CharlieW112/PROJ300/CAD Files/Downloaded Part Files/Power Socket/IEC320-C14 BACK.jpg

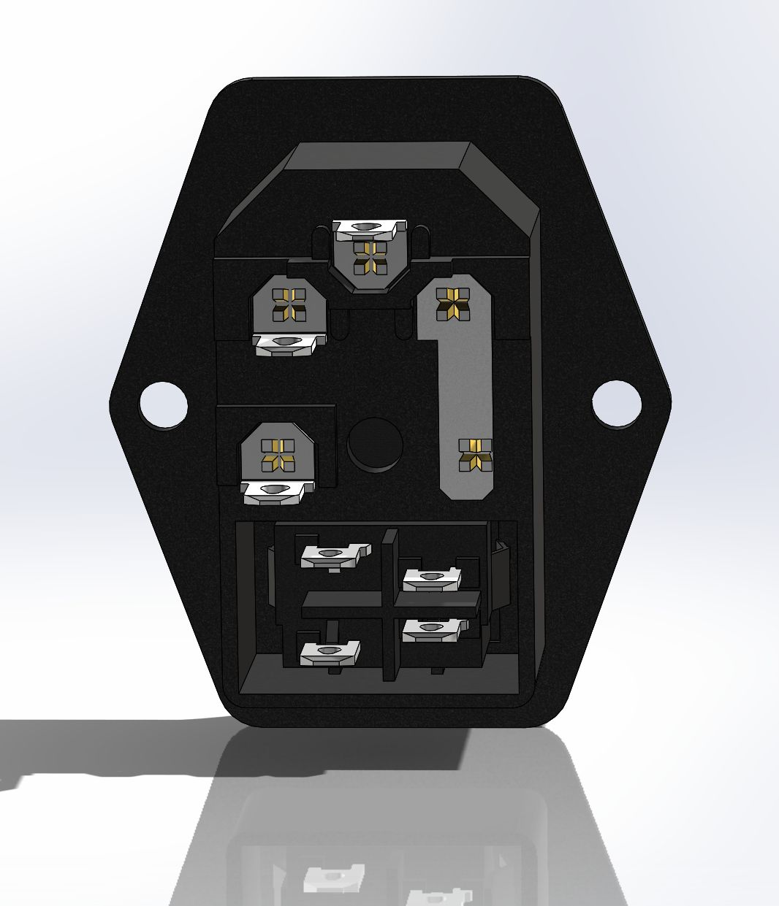
CAD Files/Downloaded Part Files/Power Socket/IEC320-C14 BACK.jpg
