CharlieW112/PROJ300/CAD Files/Downloaded Part Files/Power Socket/IEC320-C14 FRONT.jpg

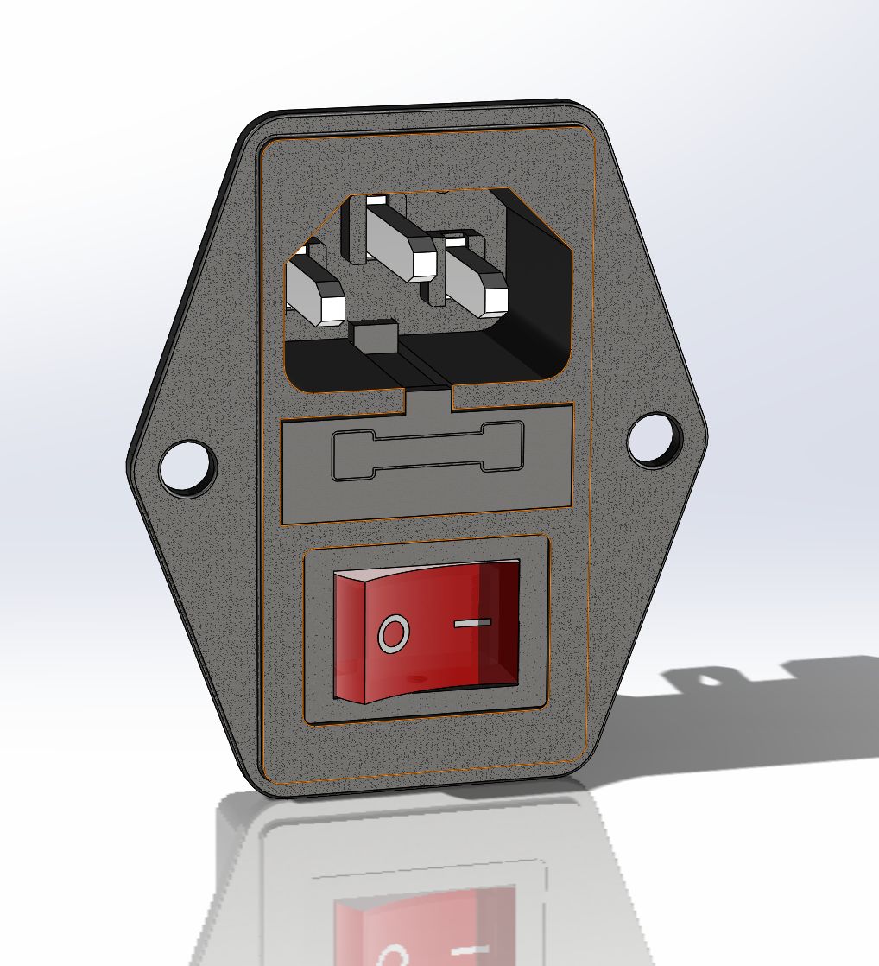
CAD Files/Downloaded Part Files/Power Socket/IEC320-C14 FRONT.jpg
