CharlieW112/PROJ300/CAD Files/Downloaded Part Files/3.5 LCD/AliExpress Dimensions.jpg

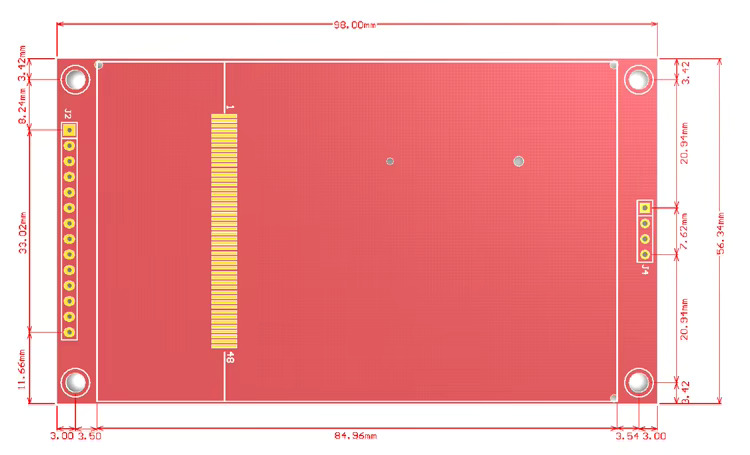
CAD Files/Downloaded Part Files/3.5 LCD/AliExpress Dimensions.jpg
