CharlieW112/PROJ300/CAD Files/Downloaded Part Files/5mm RGB LED/2.png

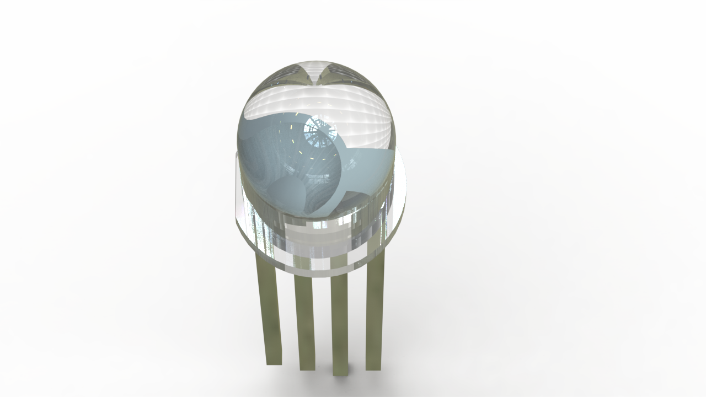
CAD Files/Downloaded Part Files/5mm RGB LED/2.png
