CharlieW112/PROJ300/CAD Files/Downloaded Part Files/Binding Posts/Low-Current/Rendering1.PNG

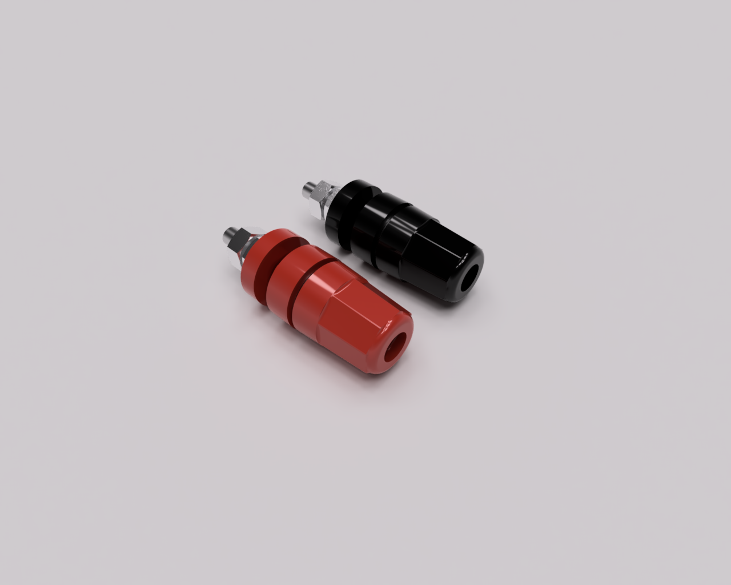
CAD Files/Downloaded Part Files/Binding Posts/Low-Current/Rendering1.PNG
