CharlieW112/PROJ300/CAD Files/Downloaded Part Files/Ethernet Port/RJ45 PanelMount.jpg

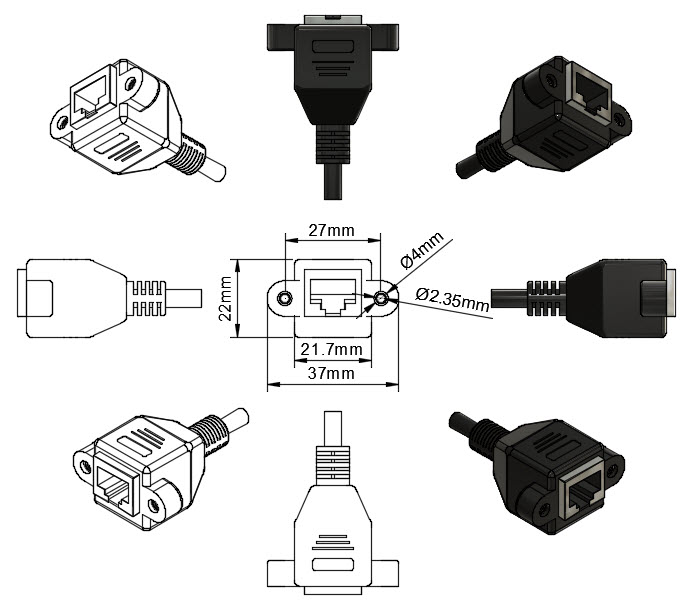
CAD Files/Downloaded Part Files/Ethernet Port/RJ45 PanelMount.jpg
