CharlieW112/PROJ300/CAD Files/Downloaded Part Files/Fans/80x80x25/80x80x25 fan.306.jpg

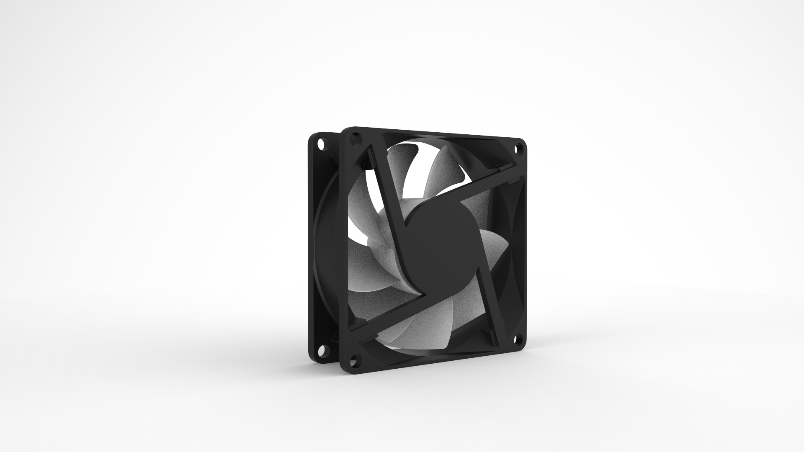
CAD Files/Downloaded Part Files/Fans/80x80x25/80x80x25 fan.306.jpg
