CharlieW112/PROJ300/CAD Files/Downloaded Part Files/Membrane Keypad/keypad-16keymembrane.jpg

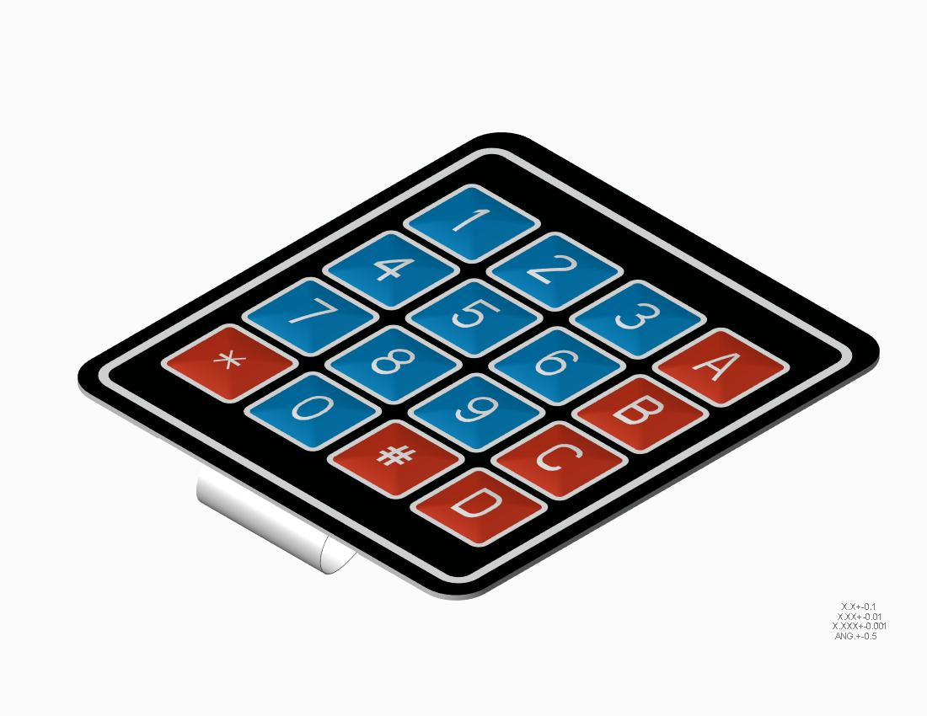
CAD Files/Downloaded Part Files/Membrane Keypad/keypad-16keymembrane.jpg
