CharlieW112/PROJ300/CAD Files/Downloaded Part Files/Power Line Filter/CW4EL2-10A-T EMI.jpg

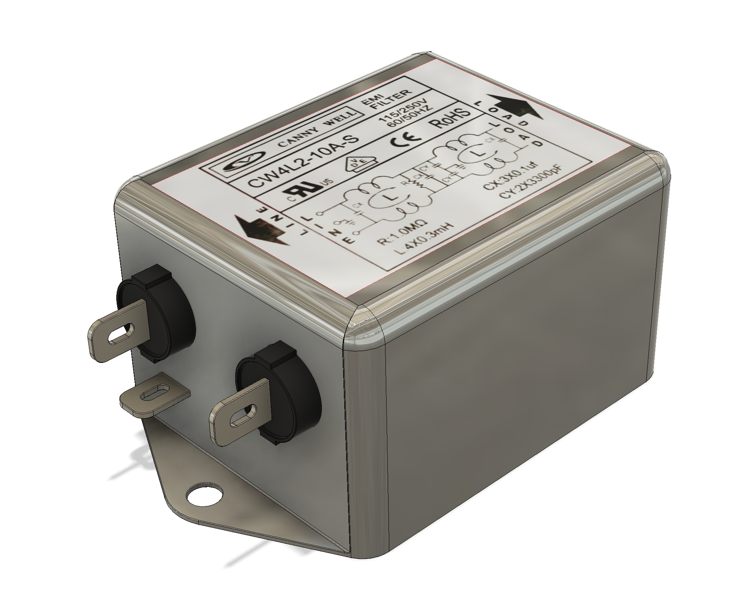
CAD Files/Downloaded Part Files/Power Line Filter/CW4EL2-10A-T EMI.jpg
