CharlieW112/PROJ300/LTSpice/Test Setups/VCCS V2/VCCS Simple Schematic.png

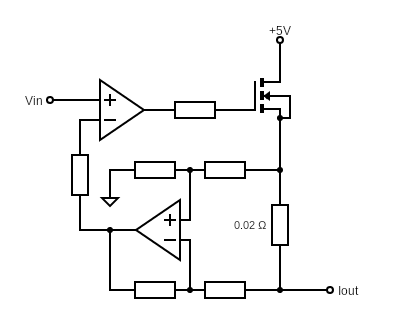
LTSpice/Test Setups/VCCS V2/VCCS Simple Schematic.png
