CharlieW112/PROJ300/CAD Files/Downloaded Part Files/Fans/80x80x25/80x80x25 9 blade fan.SLDASM

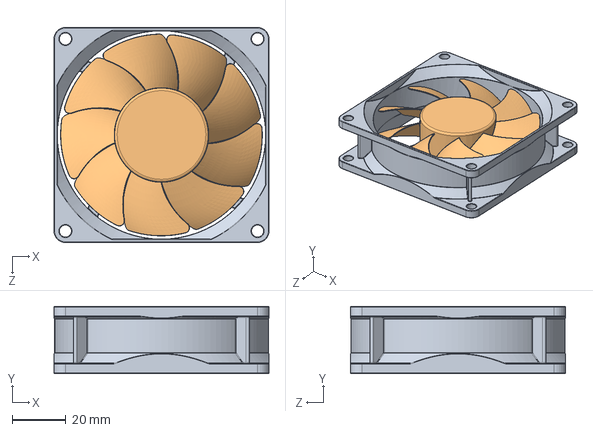
[picture p20: CAD file, 2025-05-07]
CAD Files/Downloaded Part Files/Fans/80x80x25/80x80x25 9 blade fan.SLDASM
80.0 x 25.0 x 80.0 mm
80x80x25 fan frame
80x80x25 fan blade
