CharlieW112/PROJ300/CAD Files/Downloaded Part Files/5mm RGB LED/Led RGB 5mm.STEP

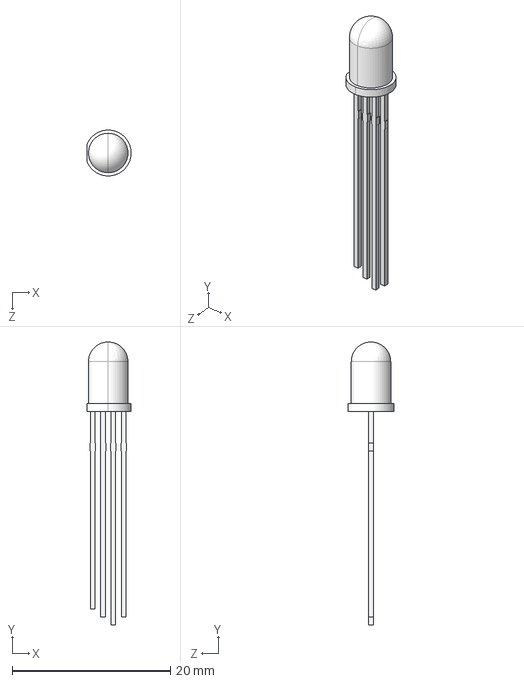
[picture p21: CAD file, 2025-05-07]
CAD Files/Downloaded Part Files/5mm RGB LED/Led RGB 5mm.STEP
5.60 x 35.8 x 5.80 mm
Lente^Led RGB 5mm
Terminais^Led RGB 5mm
