CharlieW112/PROJ300/CAD Files/Downloaded Part Files/Ethernet Port/RJ45 PanelMount.stp

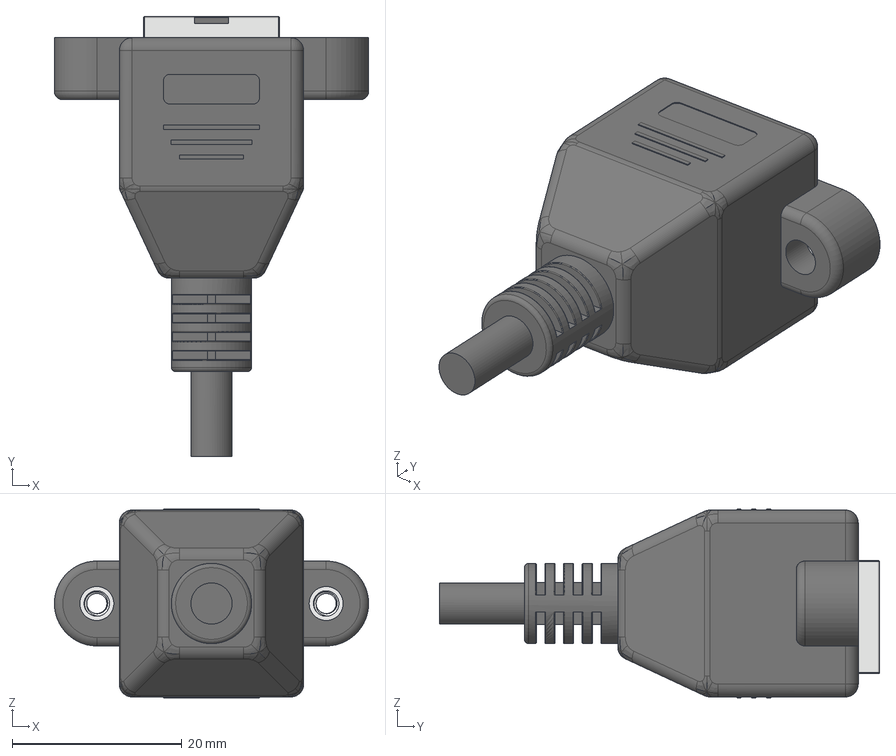
[picture p23: CAD file, 2025-05-07]
CAD Files/Downloaded Part Files/Ethernet Port/RJ45 PanelMount.stp
37.0 x 51.8 x 22.2 mm
RJ45
MetalSheet
M3 - nut 92497A200 v1 x 2
