CharlieW112/PROJ300/CAD Files/Downloaded Part Files/Fans/80x80x25/80x80x25 fan frame.SLDPRT

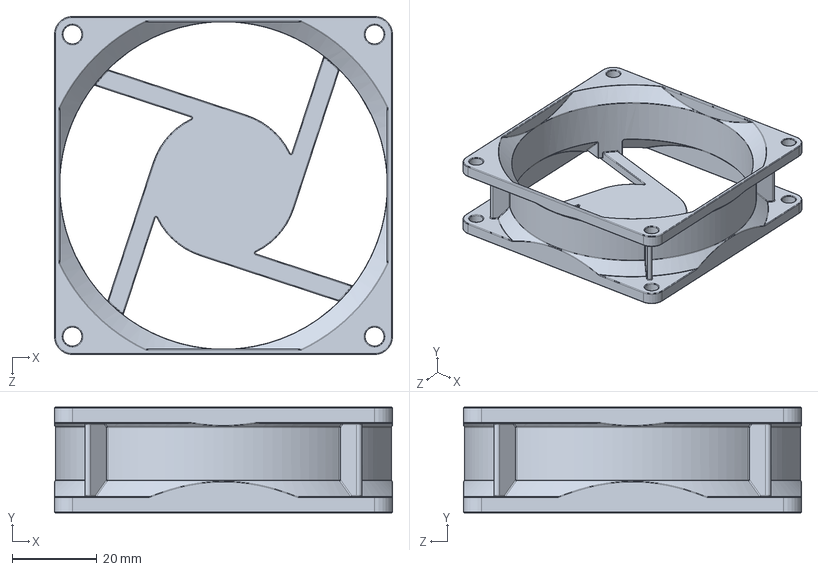
[picture p24: CAD file, 2025-05-07]
CAD Files/Downloaded Part Files/Fans/80x80x25/80x80x25 fan frame.SLDPRT
80.0 x 25.0 x 80.0 mm
