CharlieW112/PROJ300/CAD Files/Downloaded Part Files/Fans/Fan Adapter.stl

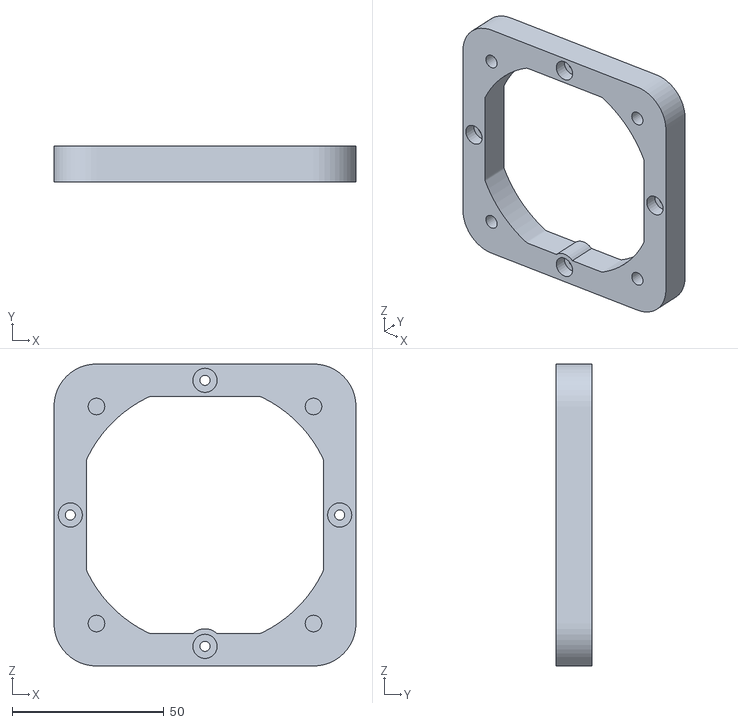
[picture p25: CAD file, 2025-05-07]
CAD Files/Downloaded Part Files/Fans/Fan Adapter.stl
99.5 x 12.0 x 99.5
