CharlieW112/PROJ300/CAD Files/Downloaded Part Files/Heatsinks/Outline1.dxf

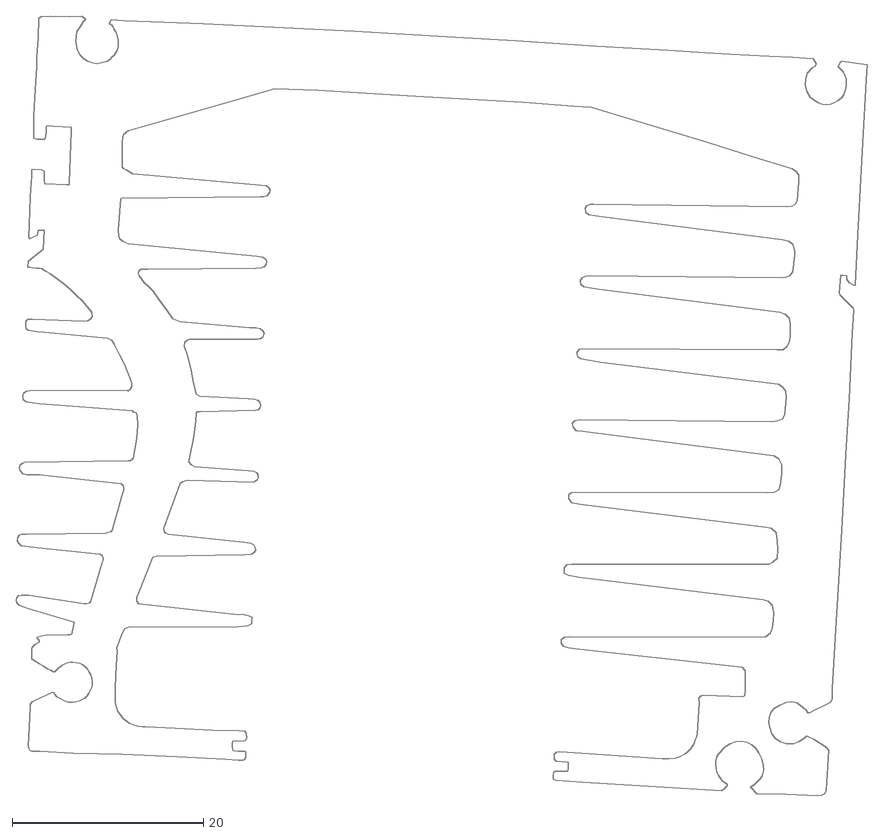
[picture p26: CAD file, 2025-05-07]
CAD Files/Downloaded Part Files/Heatsinks/Outline1.dxf
89.0 x 81.5
