CharlieW112/PROJ300/CAD Files/Downloaded Part Files/Mains Switch Indicating/PB1973GxxxxILEFx.stp

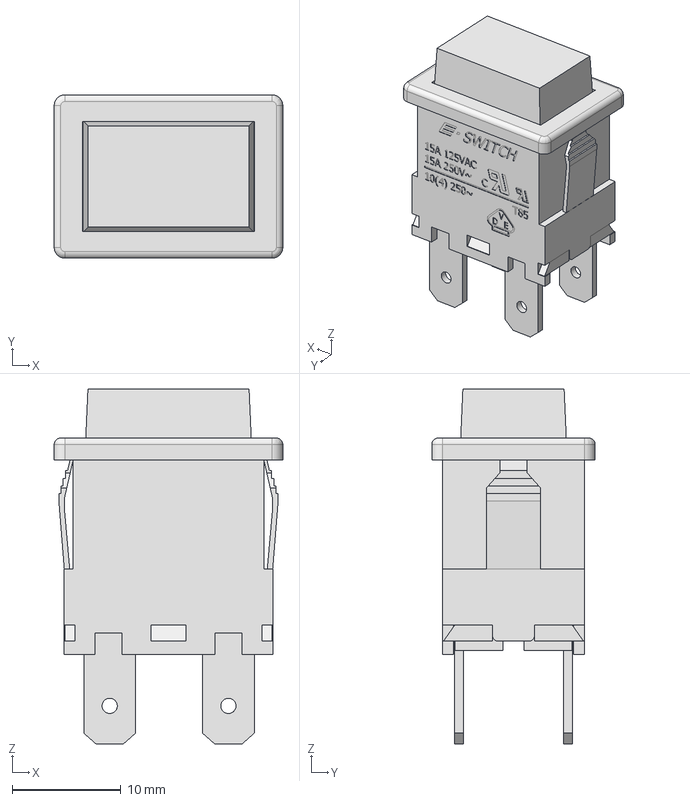
[picture p27: CAD file, 2025-05-07]
CAD Files/Downloaded Part Files/Mains Switch Indicating/PB1973GxxxxILEFx.stp
21.0 x 15.0 x 32.6 mm
