CharlieW112/PROJ300/CAD Files/Downloaded Part Files/Power Line Filter/CW4EL2-10A-T EMI v2.step

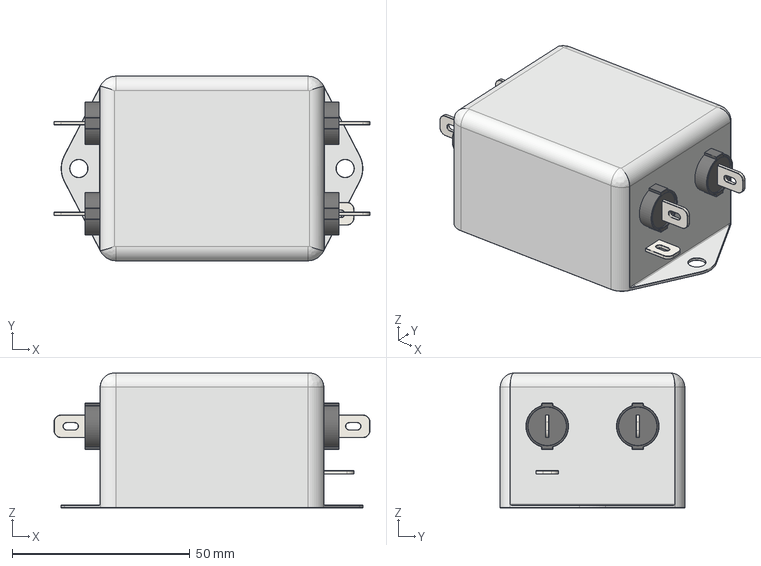
[picture p28: CAD file, 2025-05-07]
CAD Files/Downloaded Part Files/Power Line Filter/CW4EL2-10A-T EMI v2.step
89.0 x 52.0 x 38.0 mm
