CharlieW112/PROJ300/CAD Files/Downloaded Part Files/Rotary Encoder/pec11r-4x25f-sxxxx.stp

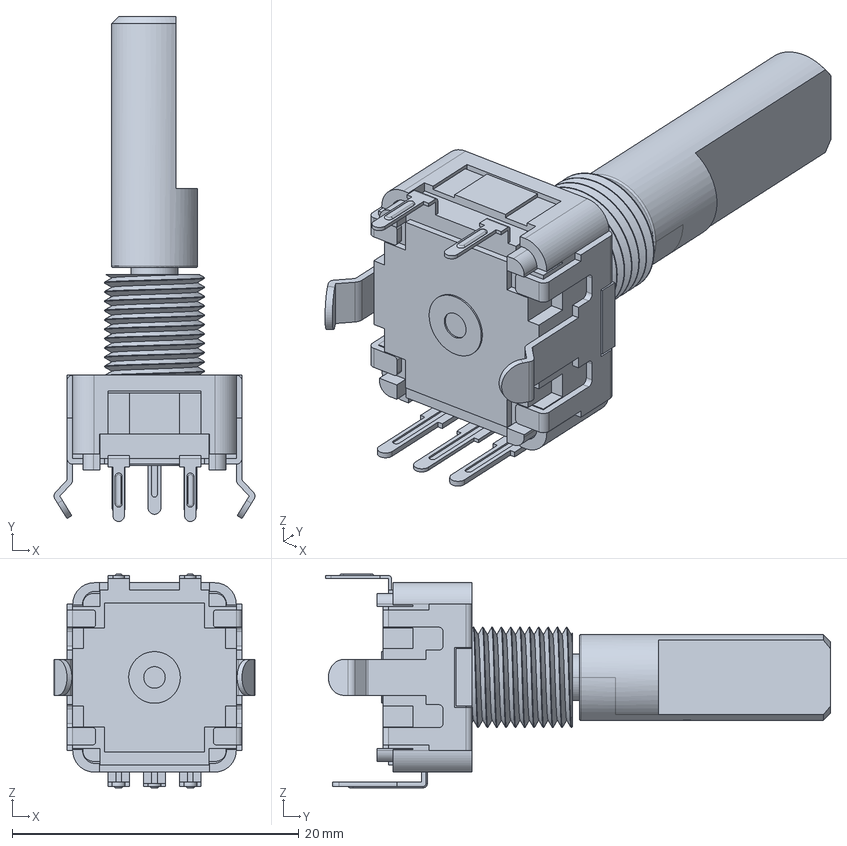
[picture p30: CAD file, 2025-05-07]
CAD Files/Downloaded Part Files/Rotary Encoder/pec11r-4x25f-sxxxx.stp
14.0 x 35.2 x 14.9 mm
