CharlieW112/PROJ300/CAD Files/Downloaded Part Files/Transistors/TO3.STEP

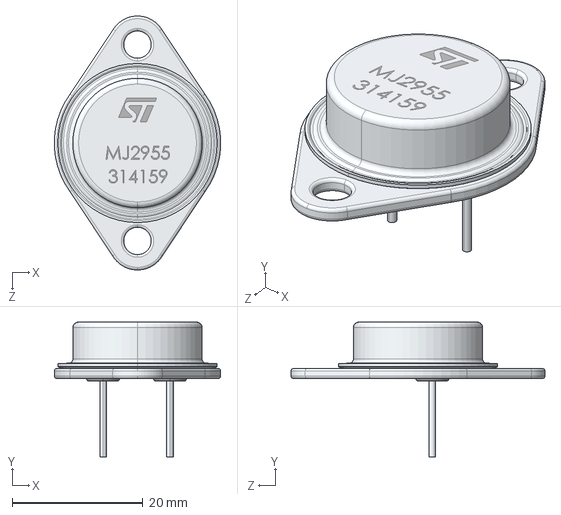
[picture p31: CAD file, 2025-05-07]
CAD Files/Downloaded Part Files/Transistors/TO3.STEP
25.5 x 20.7 x 38.9 mm
