CharlieW112/PROJ300/CAD Files/STL Files/Dust Filters/SMALL TOOL.stl

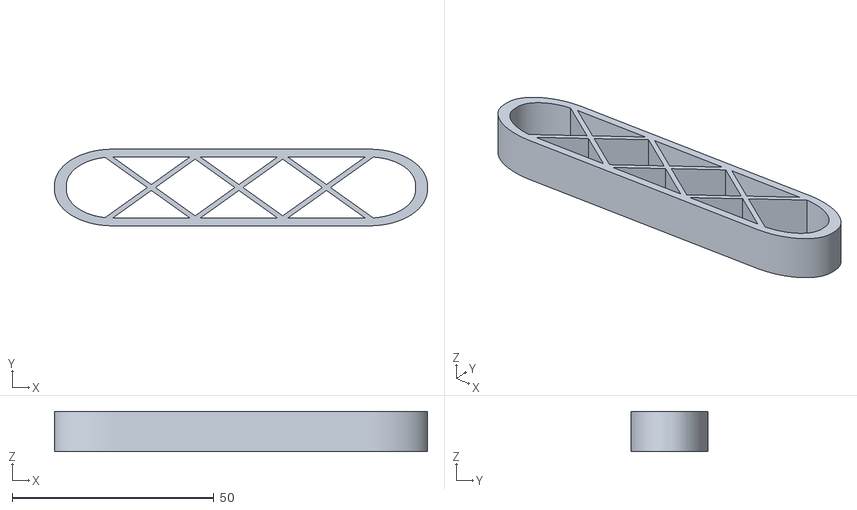
[picture p32: CAD file, 2025-05-07]
CAD Files/STL Files/Dust Filters/SMALL TOOL.stl
92.5 x 19.0 x 10.00
