CharlieW112/PROJ300/CAD Files/STL Files/Rotary Encoder Knob.stl

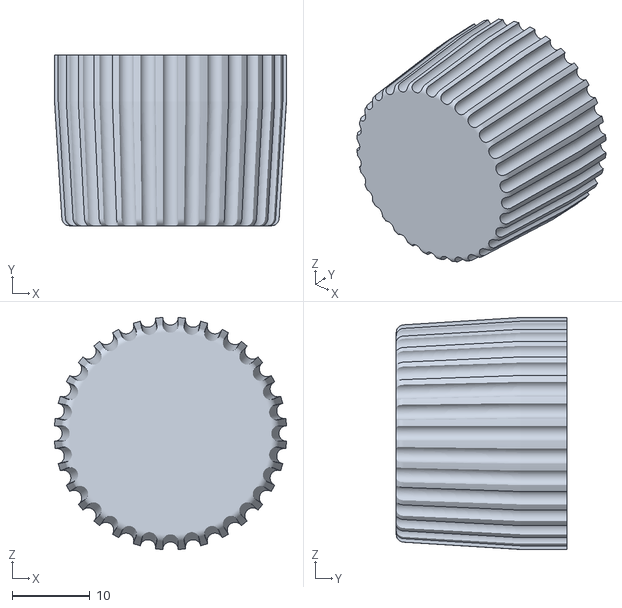
[picture p33: CAD file, 2025-05-07]
CAD Files/STL Files/Rotary Encoder Knob.stl
29.9 x 22.0 x 29.9
