CharlieW112/PROJ300/KiCAD/PWM Board/PWM Board/PWM Board.step

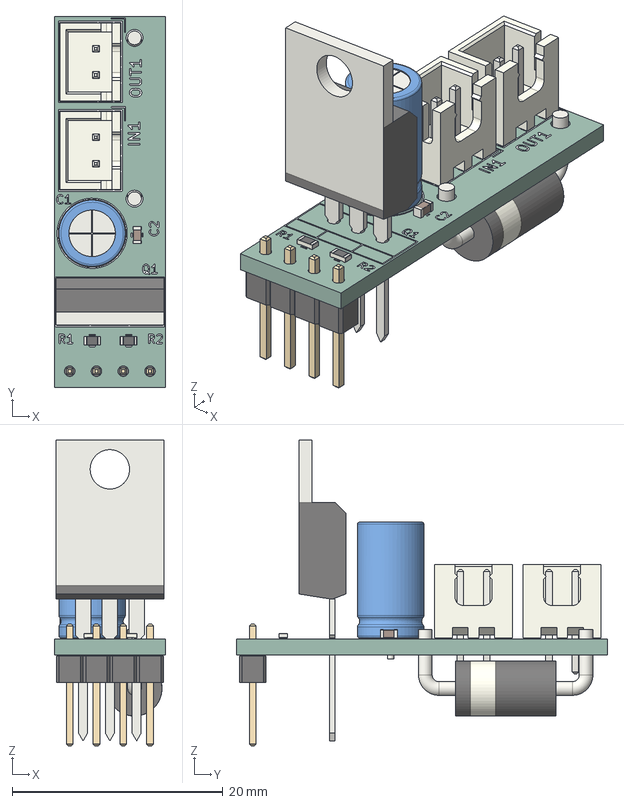
[picture p35: CAD file, 2025-05-07]
KiCAD/PWM Board/PWM Board/PWM Board.step
10.5 x 35.2 x 29.0 mm
JST_XH_B2B-XH-A_1x02_P2.50mm_Vertical x 2
C_0603_1608Metric
R_0603_1608Metric x 2
TO-220-3_Vertical
C_Radial_D6.3mm_H11.0mm_P2.50mm
D_DO-201AD_P15.24mm_Horizontal
PinHeader_1x04_P2.54mm_Vertical
PWM Board_silkscreen
PWM Board_PCB
