CharlieW112/PROJ300/CAD Files/Downloaded Part Files/Fans/80x80x25/80x80x25 fan blade.SLDPRT

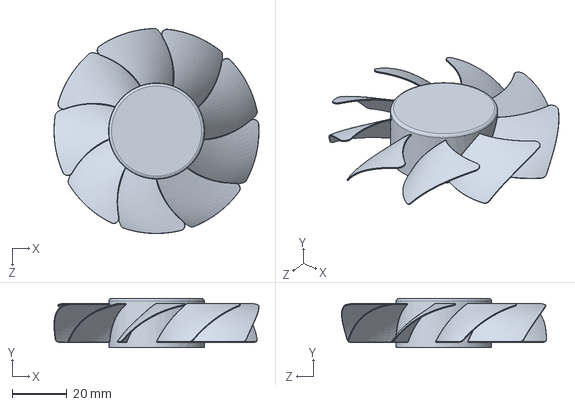
[picture p36: CAD file, 2025-05-07]
CAD Files/Downloaded Part Files/Fans/80x80x25/80x80x25 fan blade.SLDPRT
75.1 x 18.0 x 75.1 mm
