CharlieW112/PROJ300/CAD Files/STL Files/Dust Filters/MEDIUM Outer Ring.stl

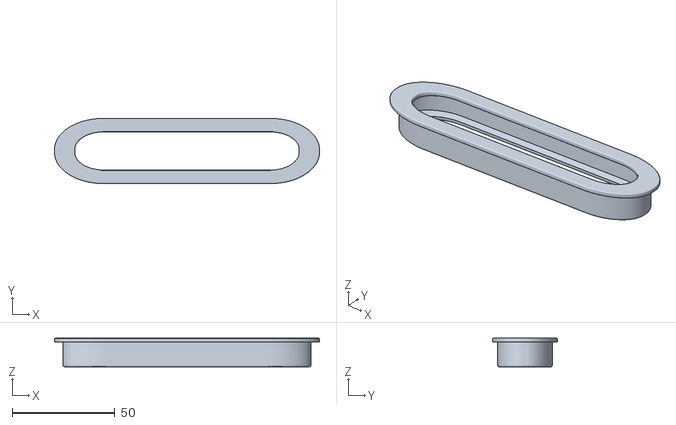
[picture p37: CAD file, 2025-05-07]
CAD Files/STL Files/Dust Filters/MEDIUM Outer Ring.stl
129.0 x 31.7 x 14.0
