CharlieW112/PROJ300/CAD Files/STL Files/Fan Dust Filter.stl

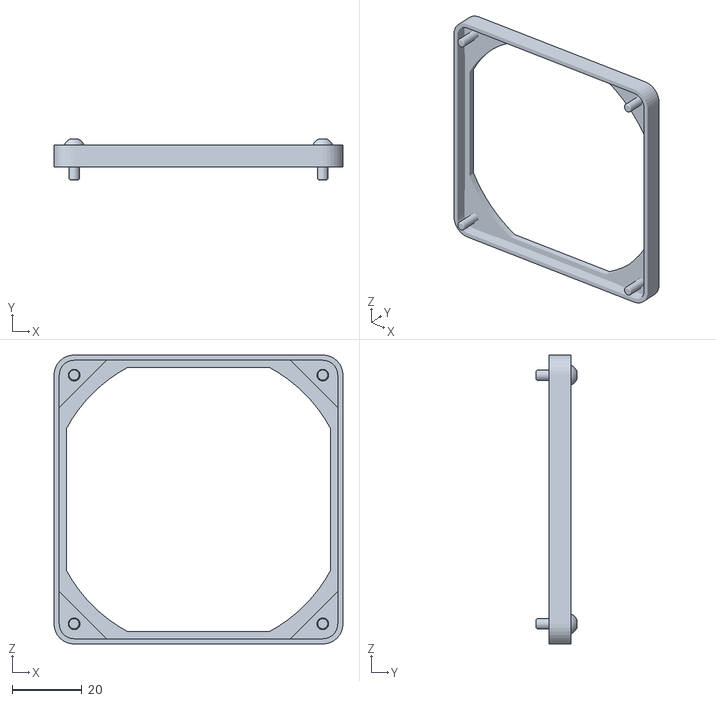
[picture p38: CAD file, 2025-05-07]
CAD Files/STL Files/Fan Dust Filter.stl
83.1 x 11.6 x 83.1
