CharlieW112/PROJ300/CAD Files/STL Files/Dust Filters/SMALL Inner Ring.stl

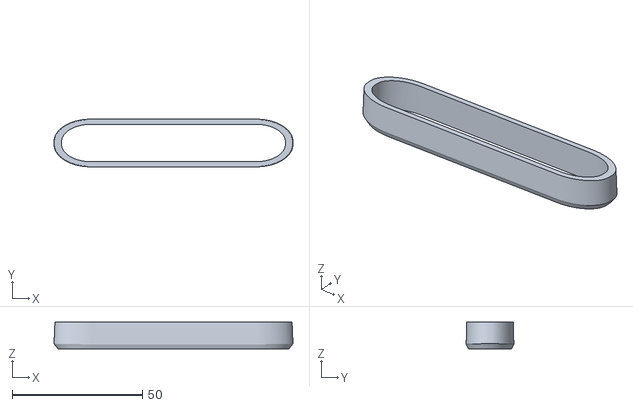
[picture p39: CAD file, 2025-05-07]
CAD Files/STL Files/Dust Filters/SMALL Inner Ring.stl
91.8 x 18.3 x 10.2
