CharlieW112/PROJ300/CAD Files/STL Files/Dust Filters/LARGE Inner Ring.3mf

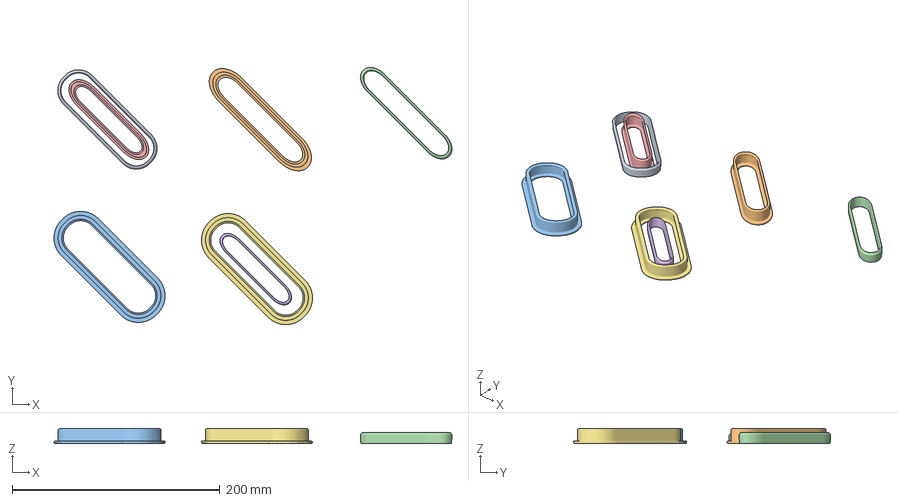
[picture p40: CAD file, 2025-05-07]
CAD Files/STL Files/Dust Filters/LARGE Inner Ring.3mf
383.2 x 247.6 x 14.0 mm
LARGE Inner Ring.stl
MEDIUM Outer Ring.stl
LARGE Outer Ring.stl x 2
MEDIUM Inner Ring.stl
SMALL Outer Ring.stl
SMALL Inner Ring.stl
