CharlieW112/PROJ300/CAD Files/STL Files/Right Dust Covers.stl

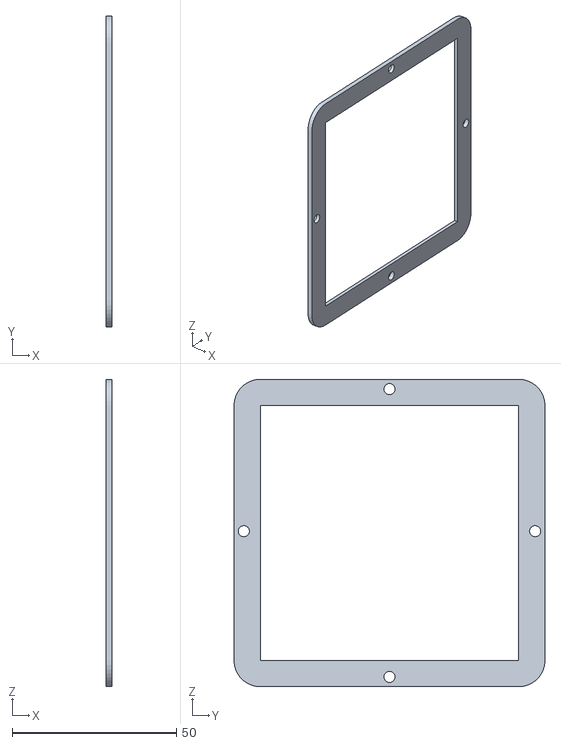
[picture p41: CAD file, 2025-05-07]
CAD Files/STL Files/Right Dust Covers.stl
1.80 x 94.8 x 93.6
