CharlieW112/PROJ300/CAD Files/STL Files/Dust Filters/MEDIUM Inner Ring.stl

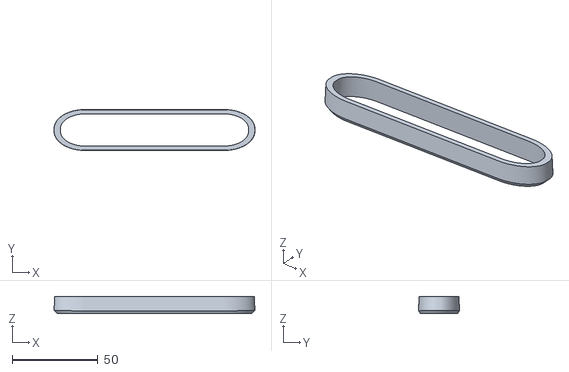
[picture p42: CAD file, 2025-05-07]
CAD Files/STL Files/Dust Filters/MEDIUM Inner Ring.stl
116.9 x 23.8 x 10.1
