CharlieW112/PROJ300/CAD Files/STL Files/Front Outer Ring.stl

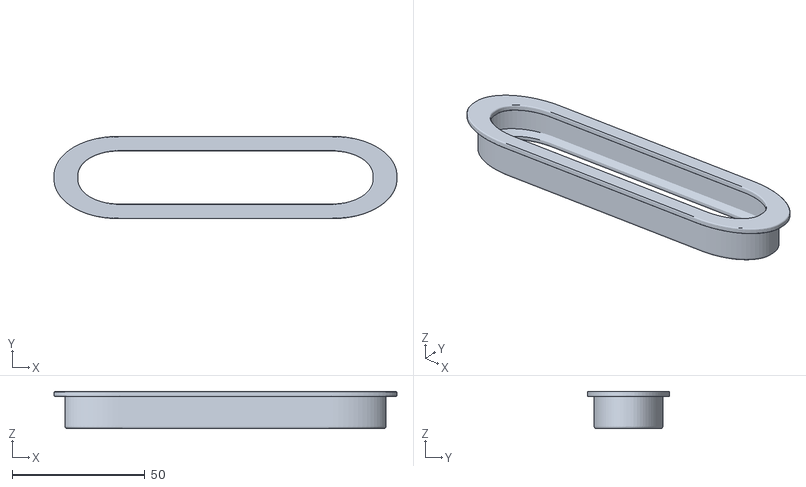
[picture p43: CAD file, 2025-05-07]
CAD Files/STL Files/Front Outer Ring.stl
129.0 x 30.9 x 14.0
