CharlieW112/PROJ300/CAD Files/STL Files/Inner Ring.stl

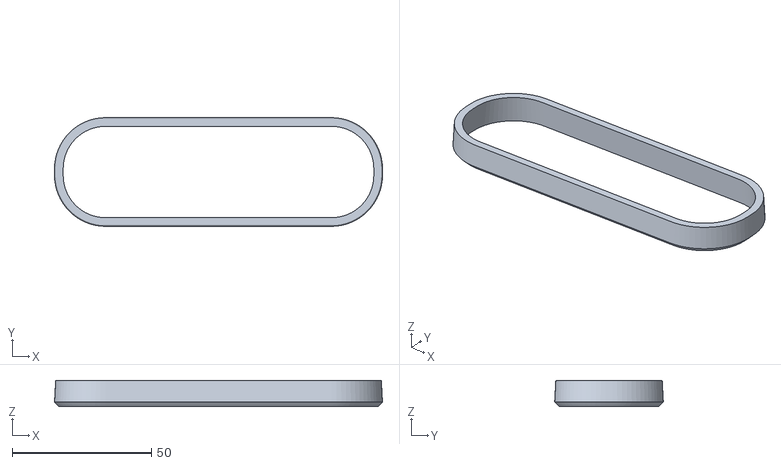
[picture p45: CAD file, 2025-05-07]
CAD Files/STL Files/Inner Ring.stl
117.6 x 39.0 x 9.50
