CharlieW112/PROJ300/CAD Files/STL Files/Binding Post Insulator.stl

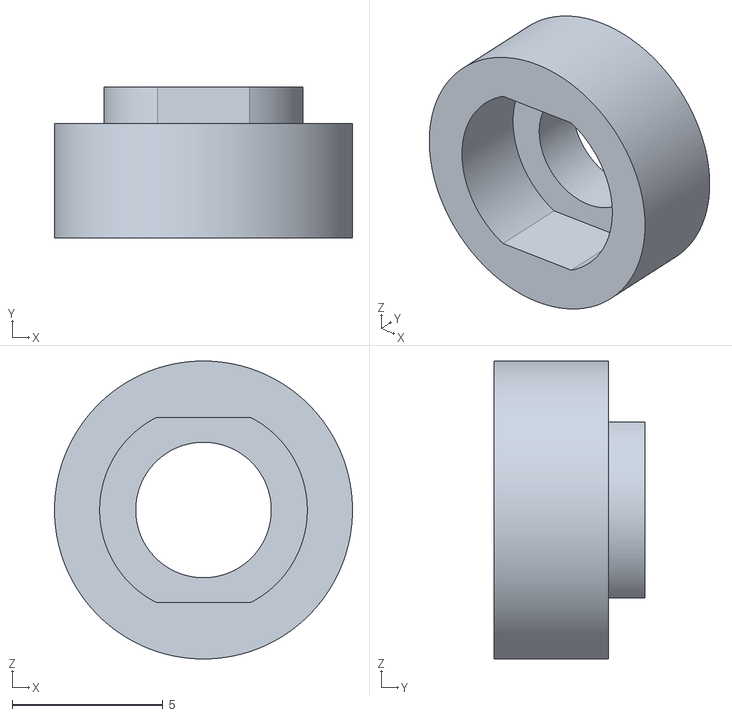
[picture p46: CAD file, 2025-05-07]
CAD Files/STL Files/Binding Post Insulator.stl
9.90 x 5.00 x 9.90
