CharlieW112/PROJ300/CAD Files/STL Files/Dust Filters/SMALL Outer Ring.stl

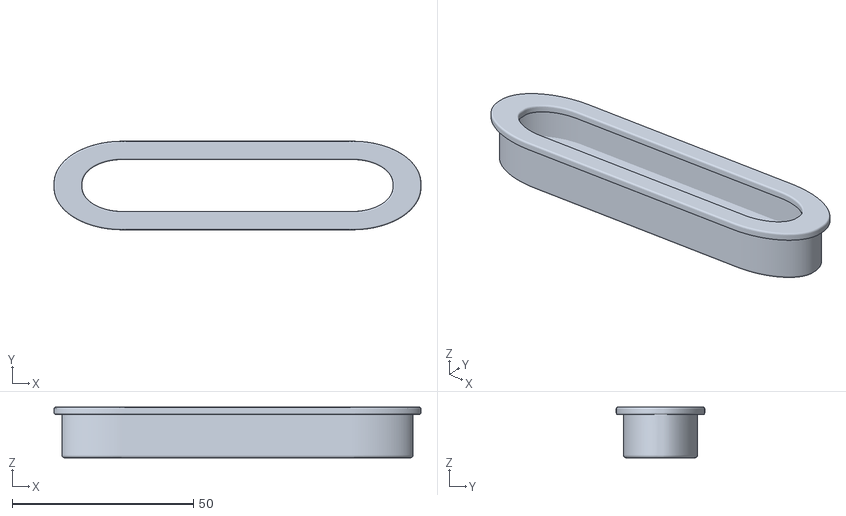
[picture p47: CAD file, 2025-05-07]
CAD Files/STL Files/Dust Filters/SMALL Outer Ring.stl
101.3 x 24.5 x 14.0
