CharlieW112/PROJ300/CAD Files/STL Files/Display Bezel.stl

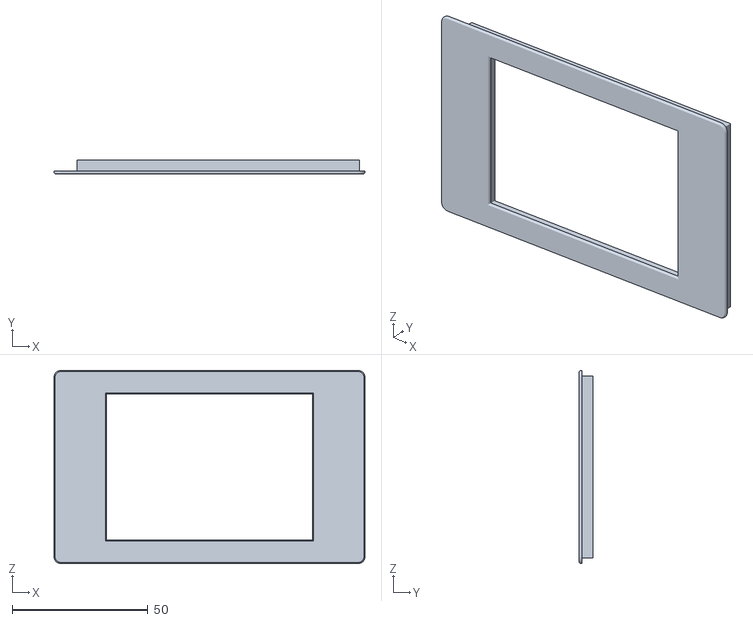
[picture p48: CAD file, 2025-05-07]
CAD Files/STL Files/Display Bezel.stl
114.4 x 5.10 x 71.0
