CharlieW112/PROJ300/CAD Files/STL Files/Mesh Temporary Spacer.stl

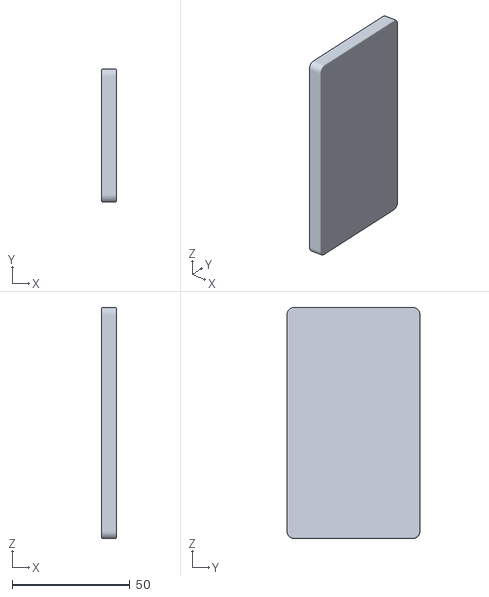
[picture p49: CAD file, 2025-05-07]
CAD Files/STL Files/Mesh Temporary Spacer.stl
6.50 x 56.4 x 98.0
