CharlieW112/PROJ300/CAD Files/STL Files/Rear Dust Filter Outline.stl

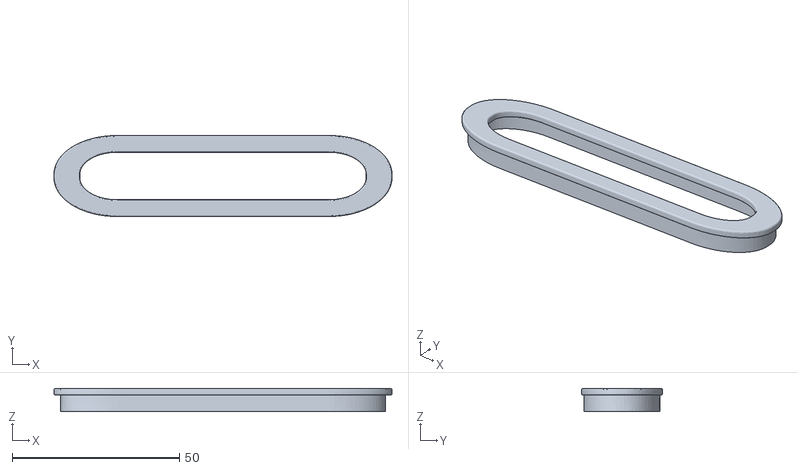
[picture p50: CAD file, 2025-05-07]
CAD Files/STL Files/Rear Dust Filter Outline.stl
101.1 x 24.2 x 7.00
