CharlieW112/PROJ300/CAD Files/STL Files/Outer Ring.stl

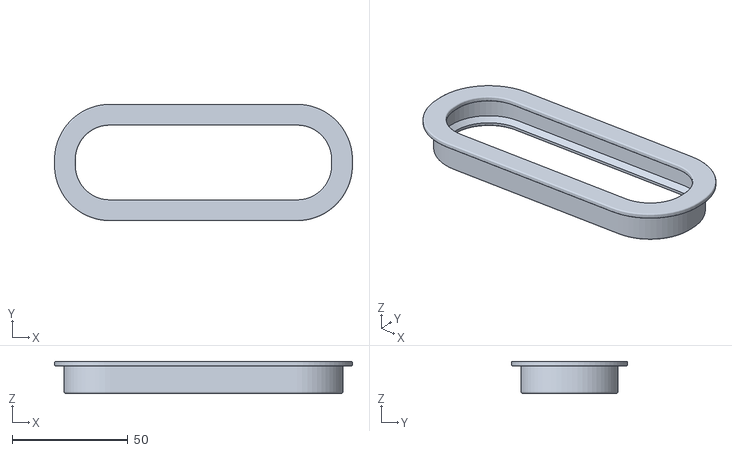
[picture p51: CAD file, 2025-05-07]
CAD Files/STL Files/Outer Ring.stl
129.0 x 50.4 x 14.0
