CharlieW112/PROJ300/CAD Files/STL Files/PSU Bracket.stl

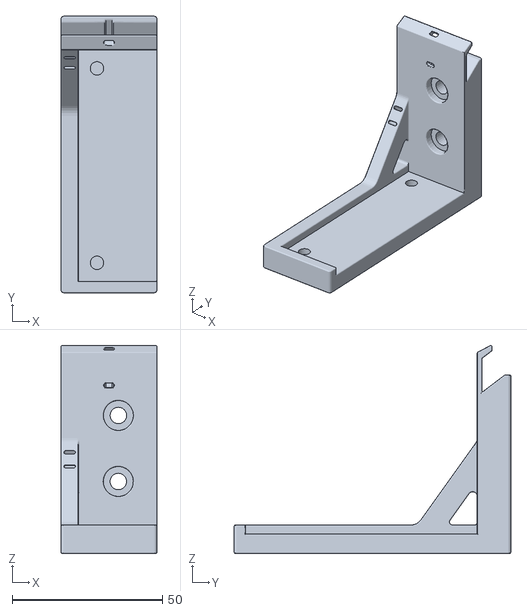
[picture p52: CAD file, 2025-05-07]
CAD Files/STL Files/PSU Bracket.stl
32.0 x 92.2 x 69.3
