CharlieW112/PROJ300/CAD Files/STL Files/M3 Spacer.stl

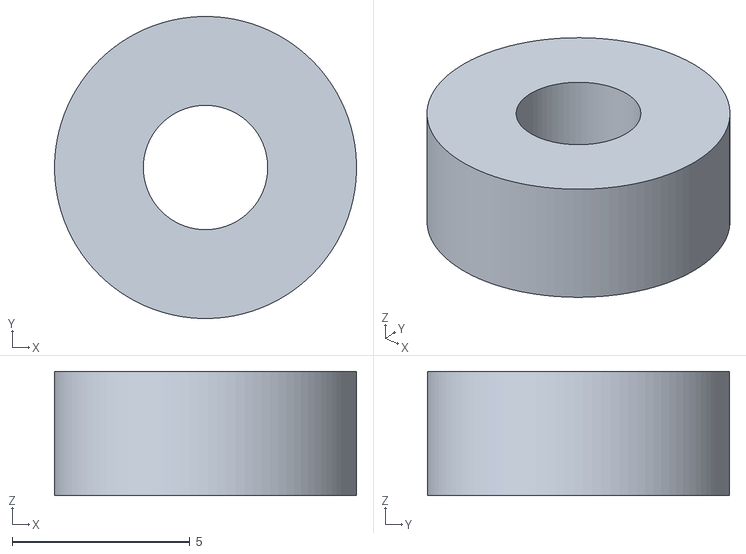
[picture p53: CAD file, 2025-05-07]
CAD Files/STL Files/M3 Spacer.stl
8.50 x 8.50 x 3.50
