CharlieW112/PROJ300/CAD Files/STL Files/Small Outer Ring Scaled Up.stl

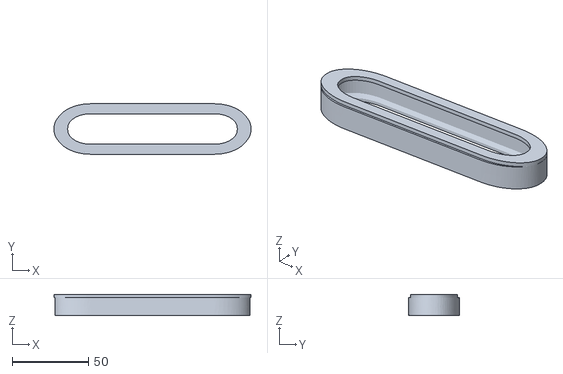
[picture p54: CAD file, 2025-05-07]
CAD Files/STL Files/Small Outer Ring Scaled Up.stl
129.0 x 33.1 x 14.0
