CharlieW112/PROJ300/CAD Files/STL Files/Front Inner Ring.stl

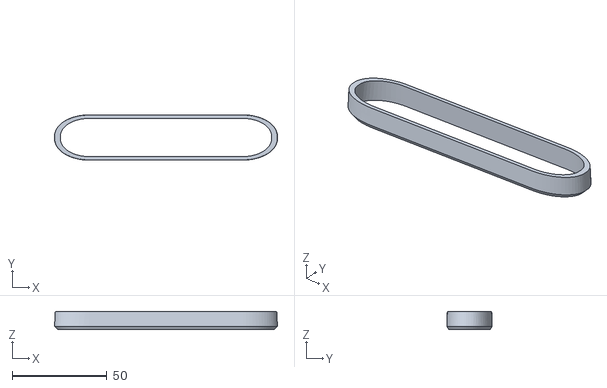
[picture p55: CAD file, 2025-05-07]
CAD Files/STL Files/Front Inner Ring.stl
117.6 x 23.9 x 9.50
