CharlieW112/PROJ300/CAD Files/STL Files/Cable Clip.stl

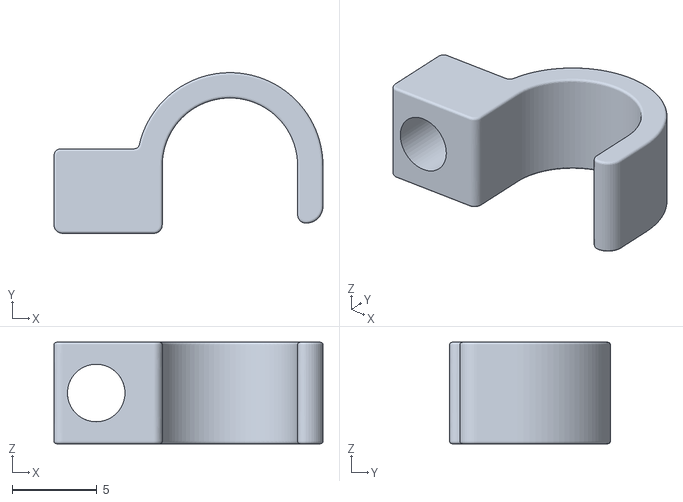
[picture p56: CAD file, 2025-05-07]
CAD Files/STL Files/Cable Clip.stl
15.9 x 9.50 x 6.00
