CharlieW112/PROJ300/CAD Files/STL Files/Filter Clip.stl

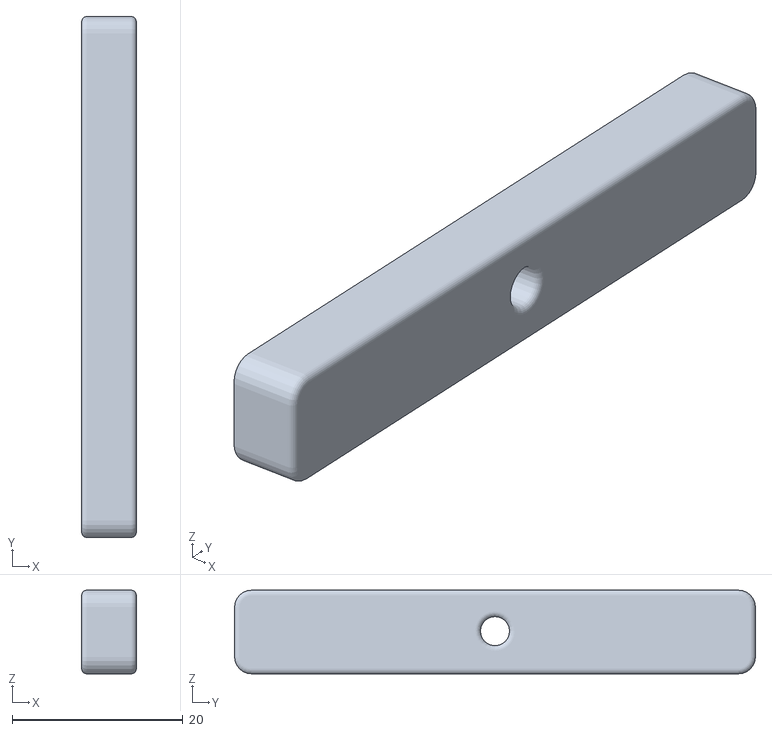
[picture p57: CAD file, 2025-05-07]
CAD Files/STL Files/Filter Clip.stl
6.40 x 61.0 x 9.80
