CharlieW112/PROJ300/CAD Files/STL Files/Body1.stl

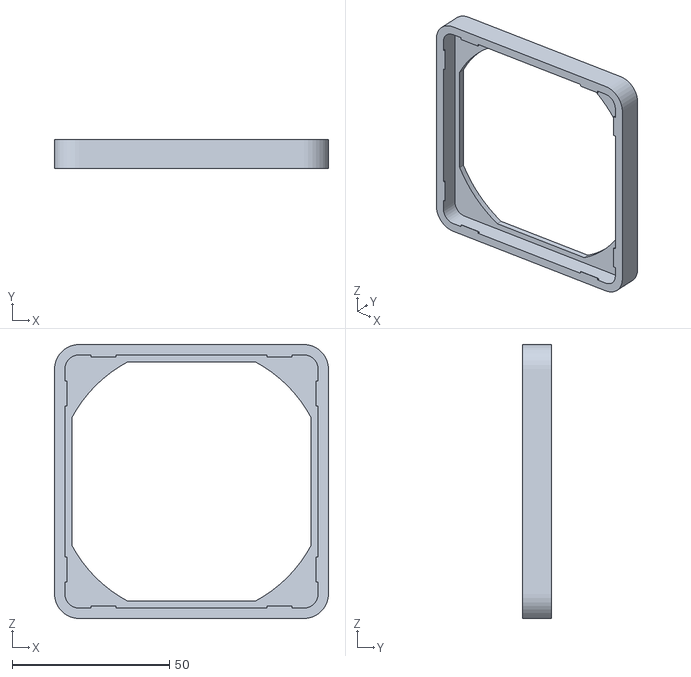
[picture p59: CAD file, 2025-05-07]
CAD Files/STL Files/Body1.stl
87.1 x 9.12 x 87.1
