CharlieW112/PROJ300/CAD Files/STL Files/Outer Body .stl

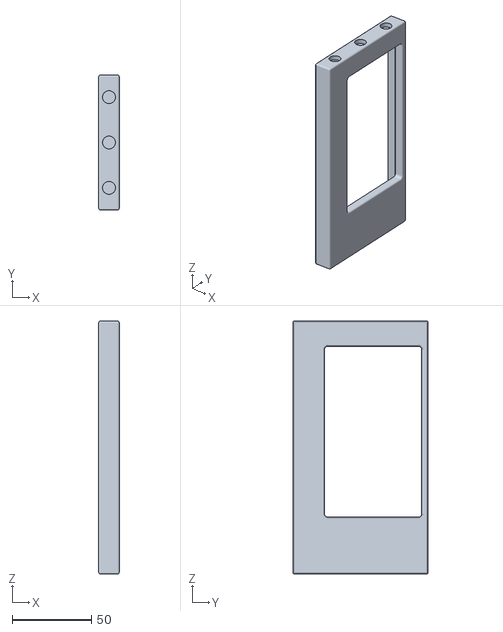
[picture p60: CAD file, 2025-05-07]
CAD Files/STL Files/Outer Body .stl
13.0 x 85.4 x 160.0
