CharlieW112/PROJ300/CAD Files/STL Files/Left Dust Cover.stl

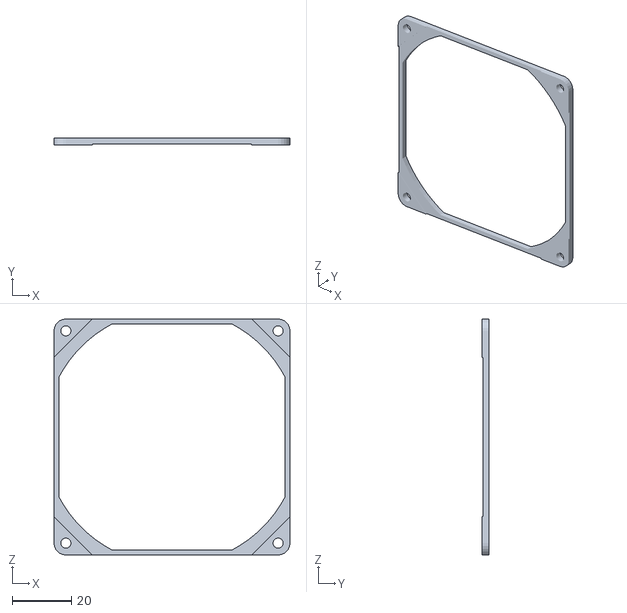
[picture p61: CAD file, 2025-05-07]
CAD Files/STL Files/Left Dust Cover.stl
79.5 x 2.50 x 79.5
