CharlieW112/PROJ300/LTSpice/Test Setups/VCCS V2/Handwritten_2025-03-16_183225.jpg

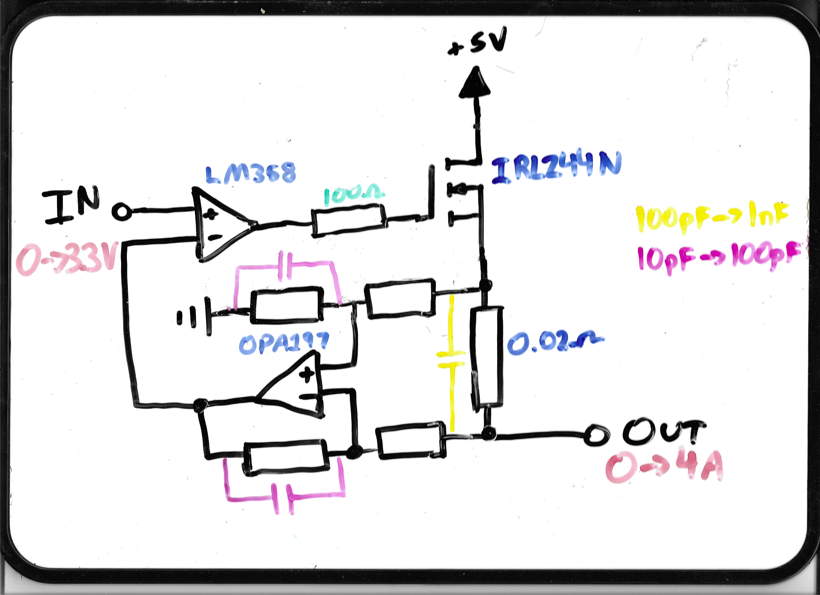
LTSpice/Test Setups/VCCS V2/Handwritten_2025-03-16_183225.jpg
