CharlieW112/PROJ300/CAD Files/V1/Programmable DC Electronic Load Drawing Complete V1 v1.pdf

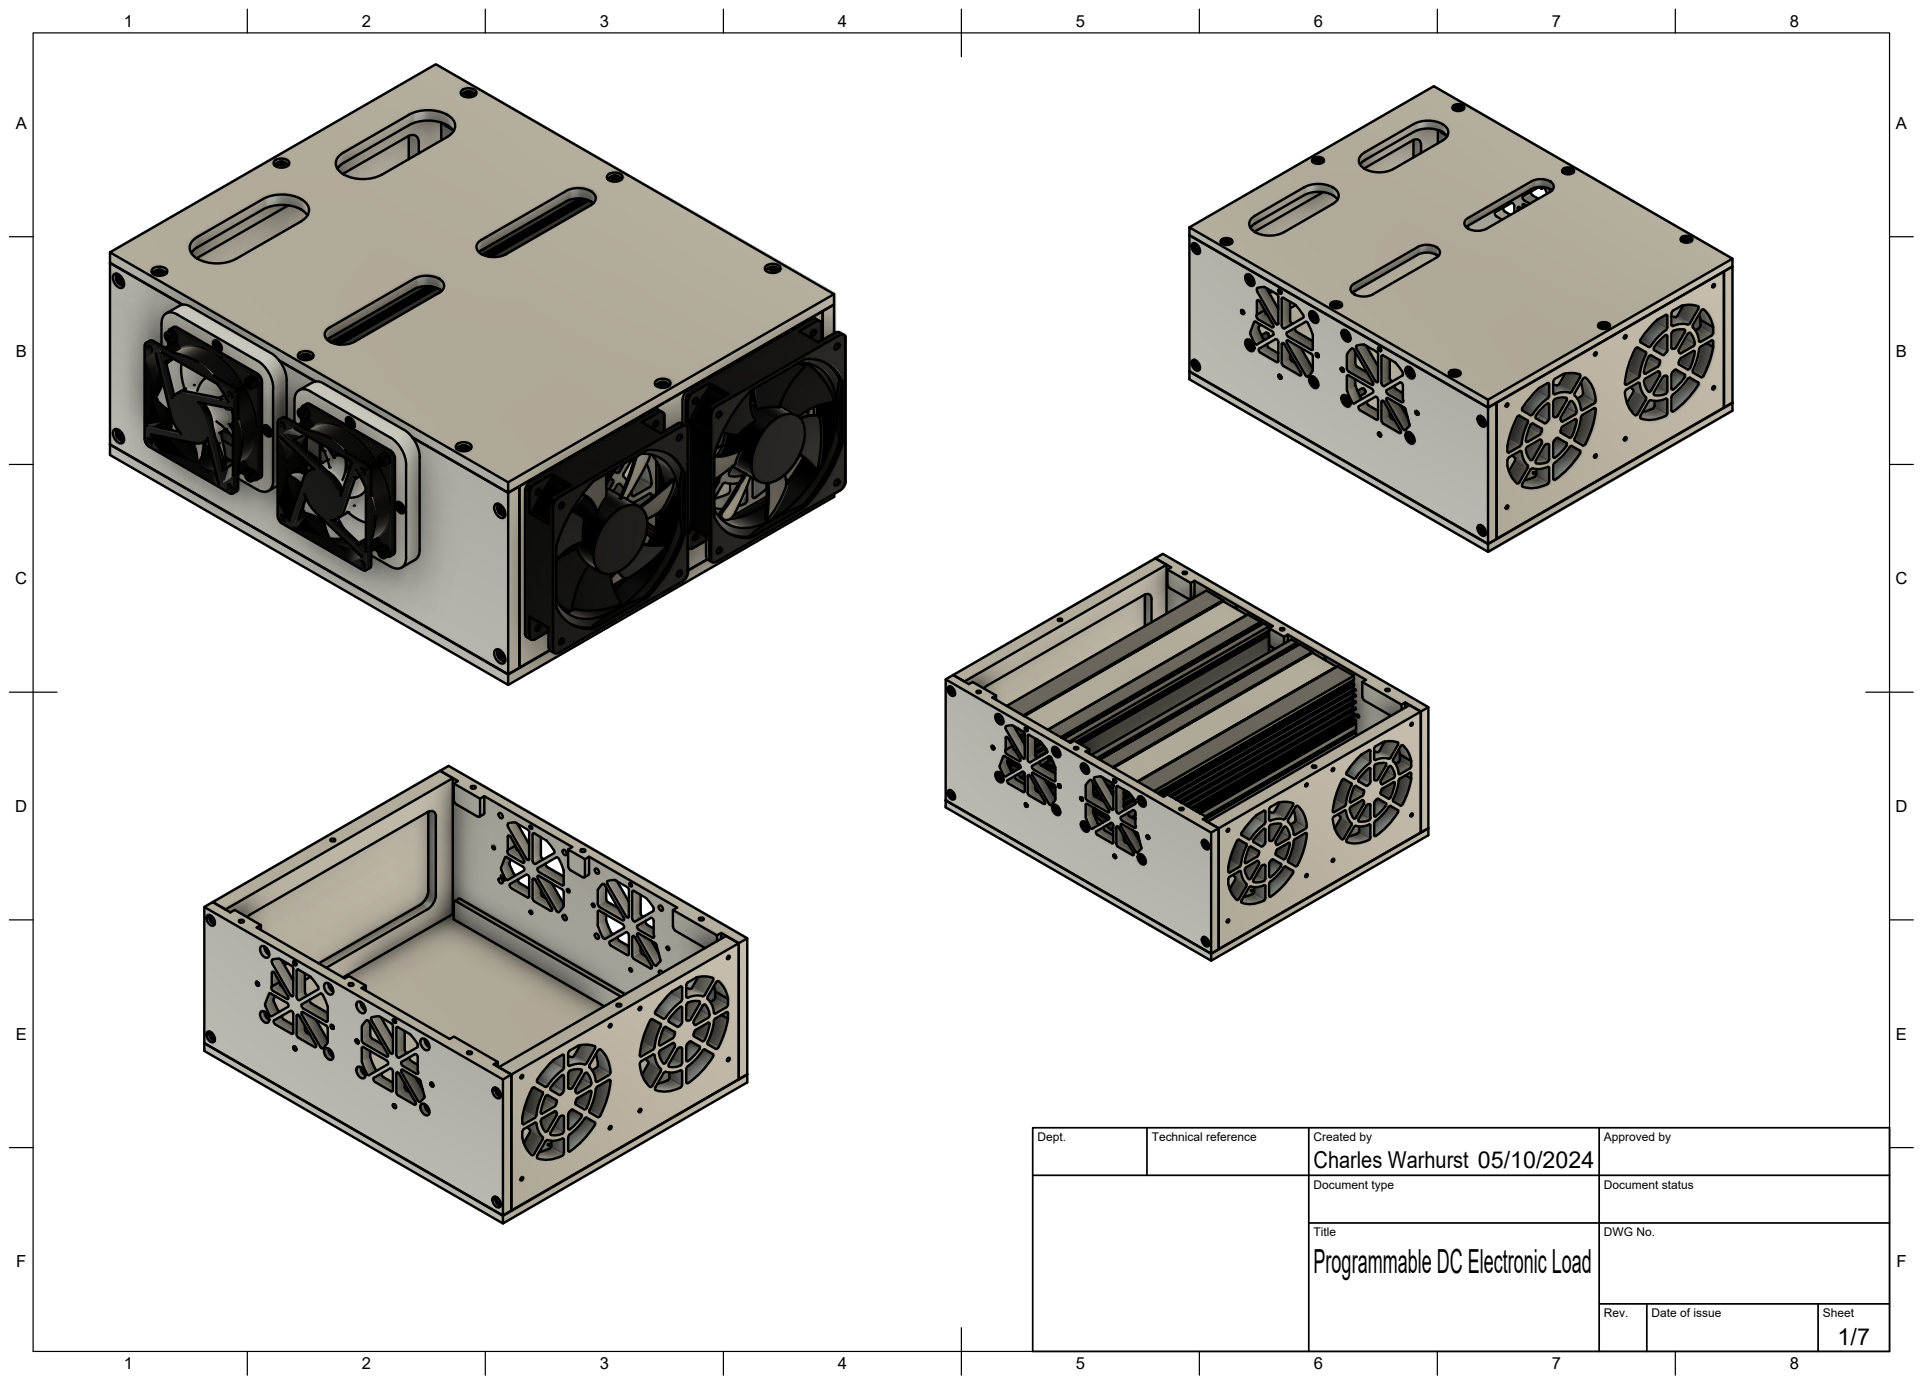
[picture p63: page 1]
Title; DWG No.; Rev.; Date of issue; Sheet

Dept. | Technical reference | Created by Charles Warhurst 05/10/2024 | Approved by

Document type | Document status

Programmable DC Electronic Load

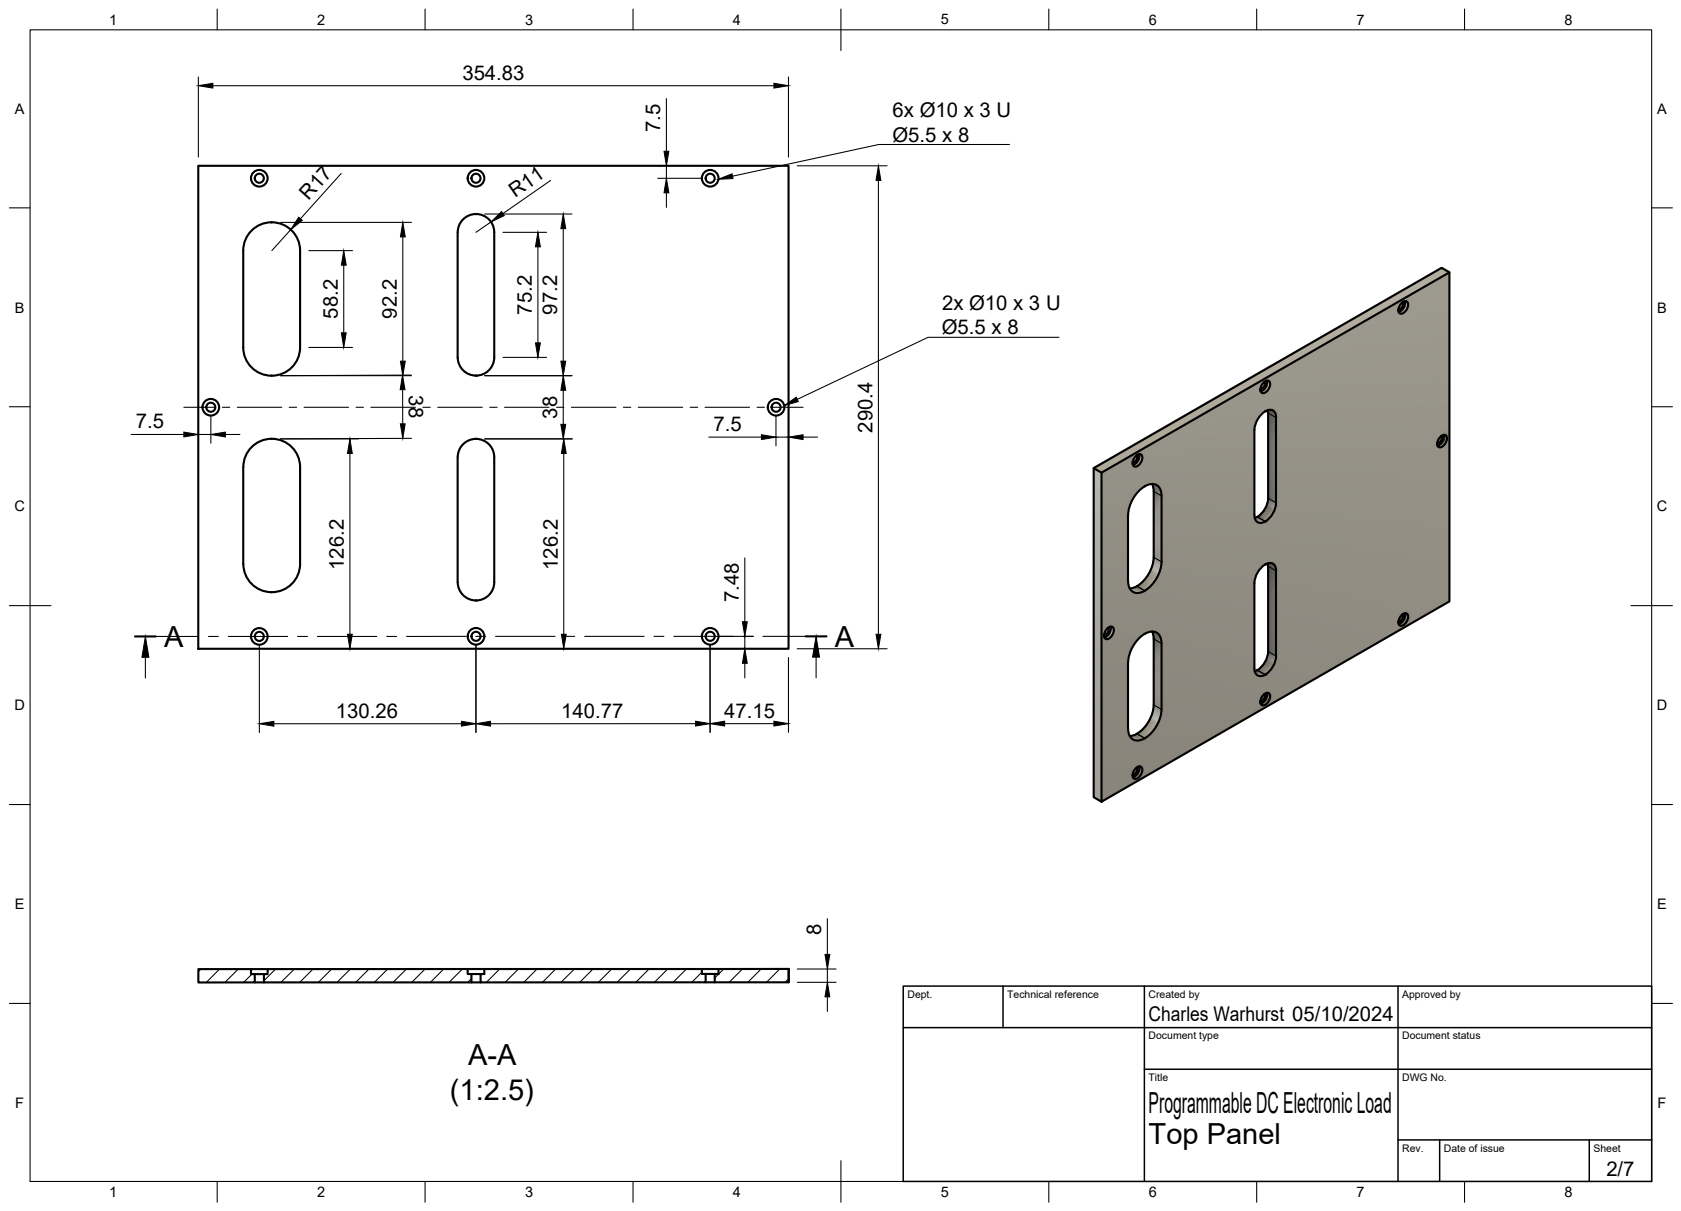
[picture p64: page 2]
Title; DWG No.

Dept. | Technical reference | Created by Charles Warhurst 05/10/2024 | Approved by

Document type | Document status

Programmable DC Electronic Load
Top Panel

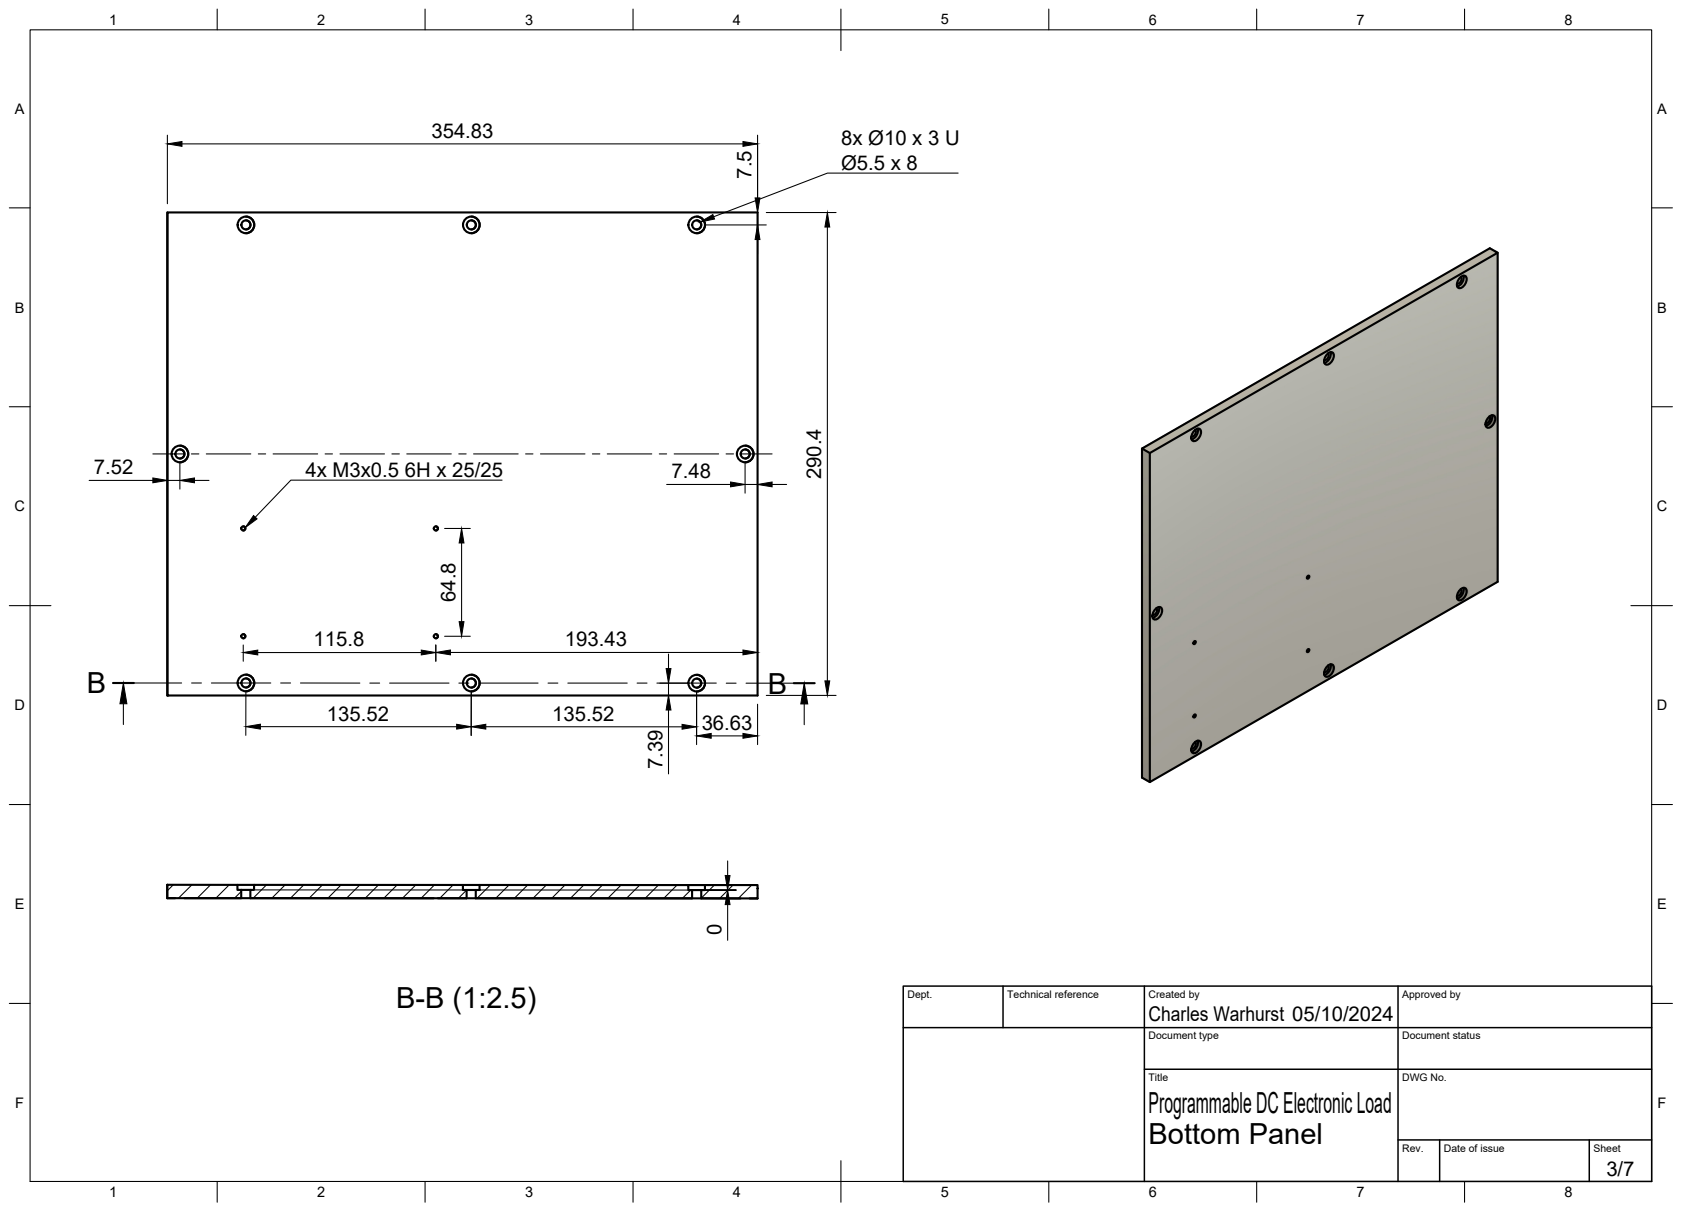
[picture p65: page 3]
Title; DWG No.

Dept. | Technical reference | Created by Charles Warhurst 05/10/2024 | Approved by

Document type | Document status

Programmable DC Electronic Load
Bottom Panel

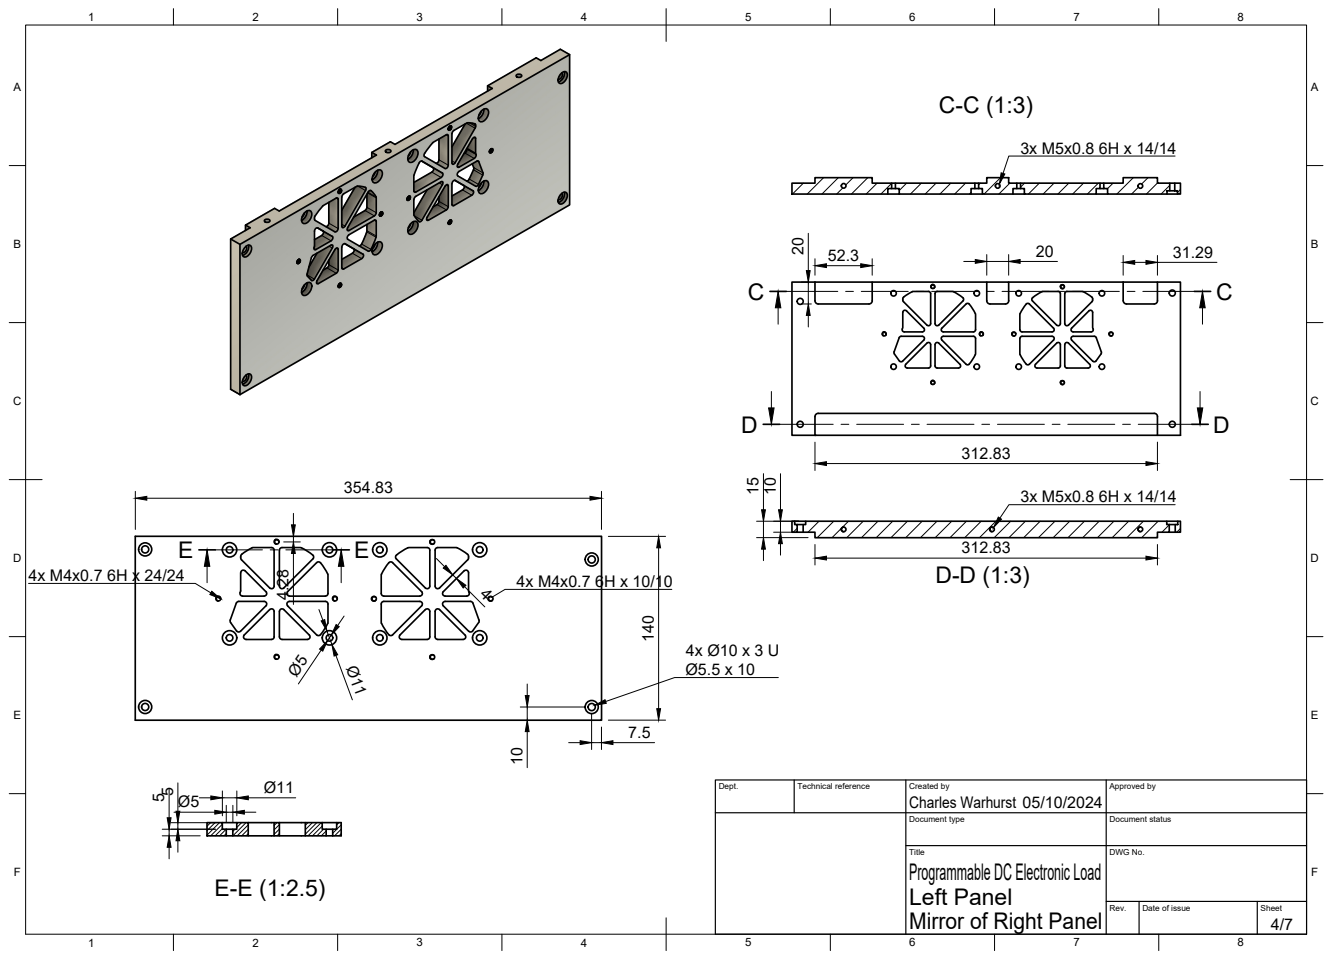
[picture p66: page 4]
Title; DWG No.

Dept. | Technical reference | Created by Charles Warhurst 05/10/2024 | Approved by

Document type | Document status

Programmable DC Electronic Load
Left Panel
Mirror of Right Panel

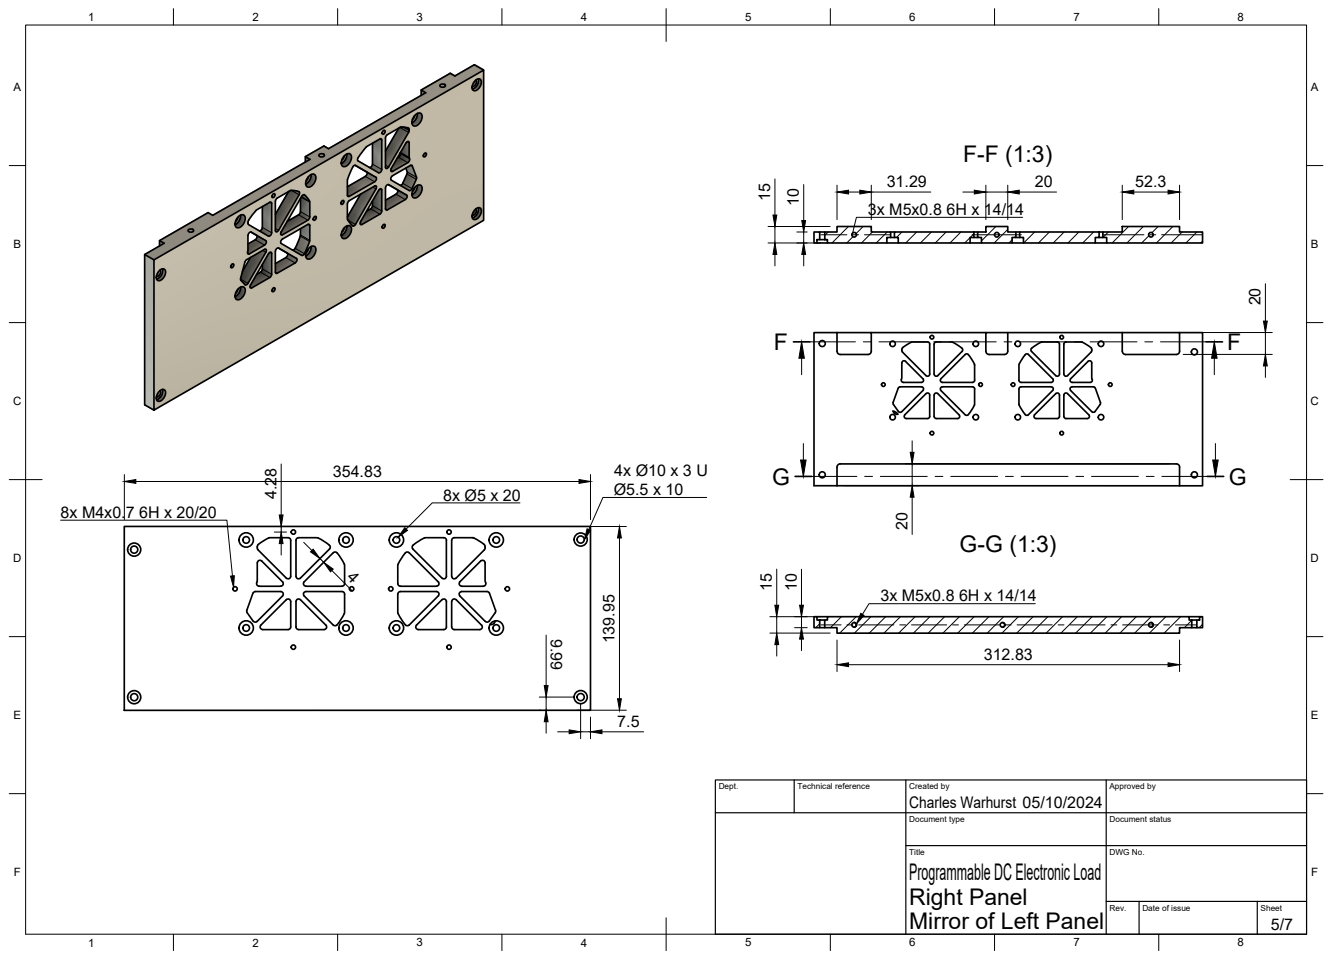
[picture p67: page 5]
Title; DWG No.

Dept. | Technical reference | Created by Charles Warhurst 05/10/2024 | Approved by

Document type | Document status

Programmable DC Electronic Load
Right Panel
Mirror of Left Panel

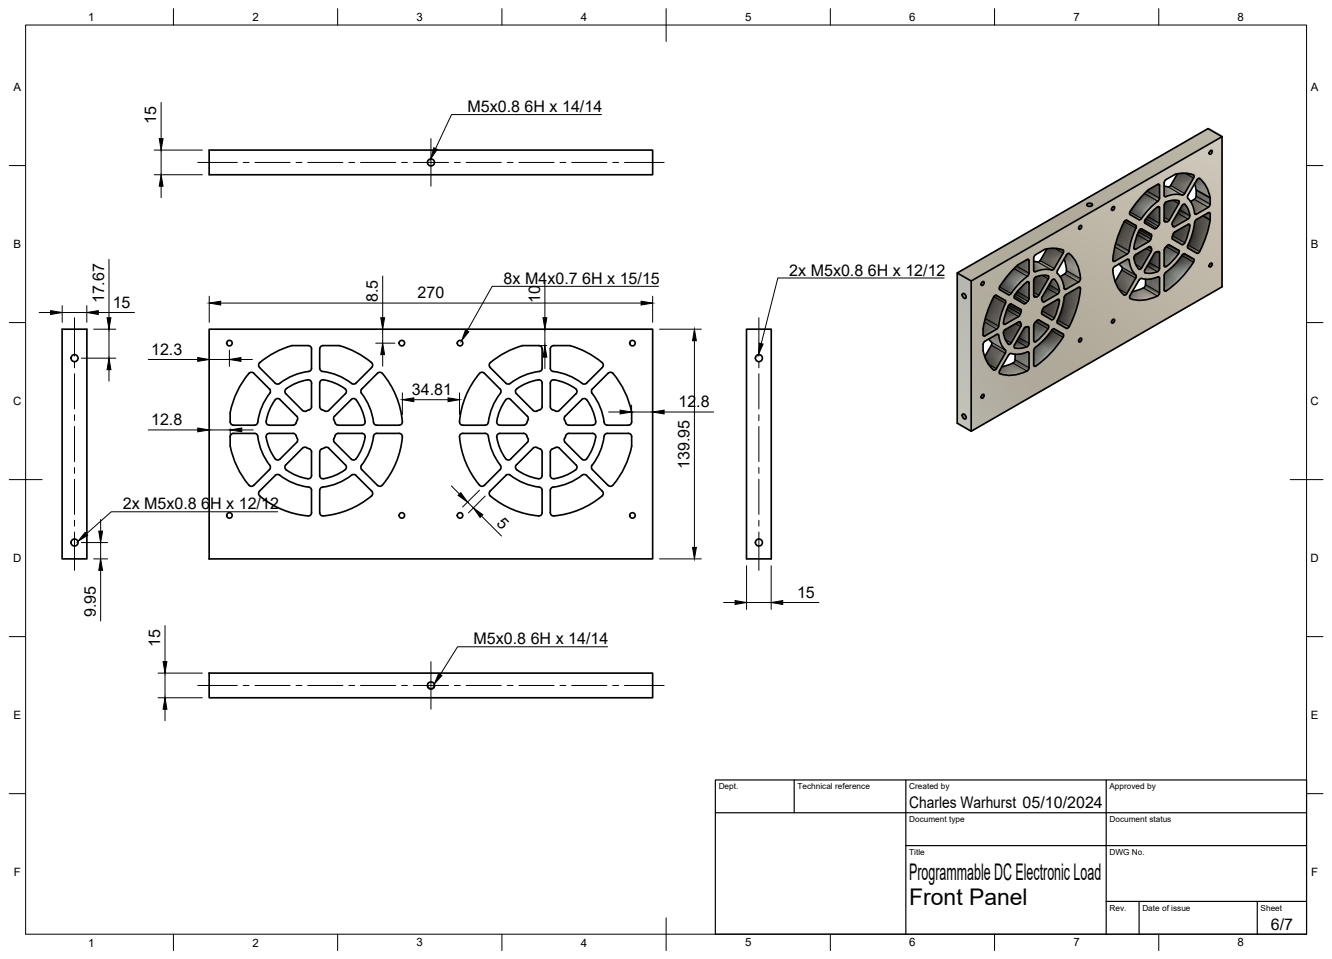
[picture p68: page 6]
Title; DWG No.; Charles Warhurst 139.95

Dept. | Technical reference | Created by 05/10/2024 | Approved by

Document type | Document status

Programmable DC Electronic Load
Front Panel

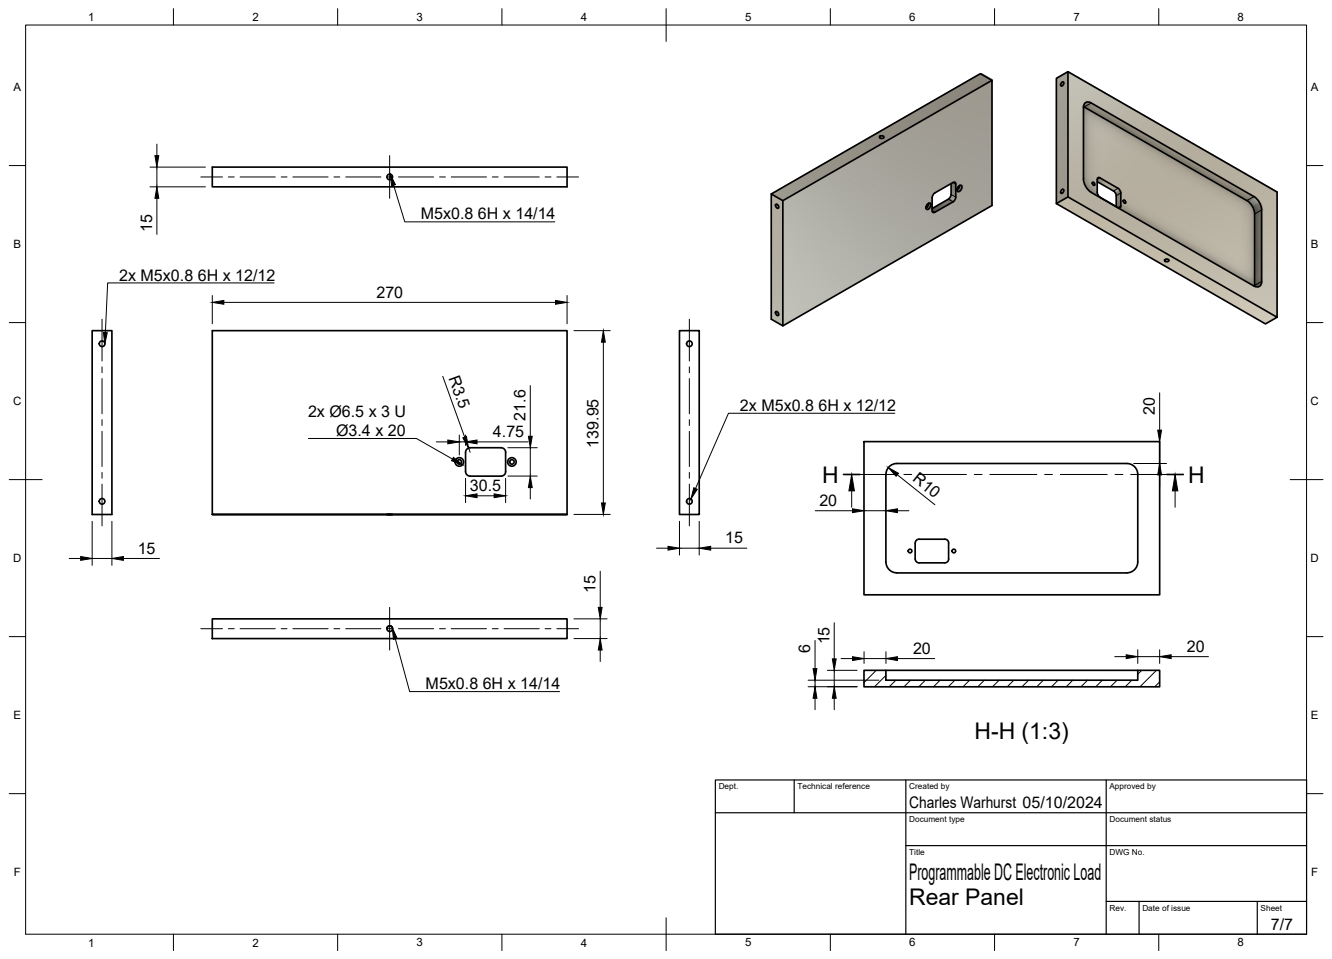
[picture p69: page 7]
Title; DWG No.; Charles Warhurst 139.95

Dept. | Technical reference | Created by 05/10/2024 | Approved by

Document type | Document status

Programmable DC Electronic Load
Rear Panel
