CharlieW112/PROJ300/LTSpice/Test Setups/VCCS V2/VCCS V2.asc

C1: cap; 100p
C2: cap; 100p
C3: cap; 680p
C4: cap; 10µ
C5: cap; 100n
C6: cap; 100n
C7: cap; 10µ
C8: cap; 100n
C9: cap; 10µ
LOAD: res; 1
R1: res; 82
R2: res; 0.02
R3: res; 100
R4: res; 220k
R5: res; 5.1k
R6: res; 5.1k
R7: res; 220k
U1: OPAx197
U2: irlz44n
U3: LM358
V1: voltage; ""
V5: voltage; 5
V6: voltage; 8
V7: voltage; 8
Named nets: 0, +5V, +8V, -8V
.dc V1 0.01 3.3 0.04
VCCS
Power Nets
Prototyped and tested
0-3.3V -> 0-4A
