CharlieW112/PROJ300/LTSpice/Test Setups/VCCS/VCCS.asc

R1: res; 220
R2: res; 0.02
R3: res; 1
R4: res; 220k
R5: res; 5.1k
R6: res; 5.1k
R7: res; 220k
R8: res; 10k
U4: OPAx197
U5: OPAx197
U6: tip120
V1: voltage; ""
V5: voltage; 5
V6: voltage; 8
V7: voltage; 8
Named nets: 0, +5V, +8V, -8V
.lib OPAx197.LIB
.lib TIP120.LIB
.dc V1 0.01 3.3 0.04
VCCS
Power Nets
DUMMY LOAD
Prototyped and tested
