CharlieW112/PROJ300/LTSpice/V1/PDCL V1.asc

C1: cap; 47p; V=50 Irms=0 Rser=0 Lser=0 mfg="Murata" pn="GRM0335C1H470JA01" type="C0G"
C2: cap; 47p; V=50 Irms=0 Rser=0 Lser=0 mfg="Murata" pn="GRM0335C1H470JA01" type="C0G"
C3: cap; 681p; V=50 Irms=0 Rser=0.002 Lser=800p mfg="Murata" pn="GRM0335C1H681JE01D" type="C0G/NP0"
C4: cap; 47µ; V=25 Irms=0 Rser=0 Lser=0 mfg="KEMET" pn="ESH476M025AC3AA" type="ESH"
C5: cap; 0.1µ; V=50 Irms=0 Rser=0.01 Lser=1000p mfg="Samsung Electro-Mechanics" pn="CL10B104KB8NNNC" type="X7R"
C6: cap; 0.1µ; V=50 Irms=0 Rser=0.01 Lser=1000p mfg="Samsung Electro-Mechanics" pn="CL10B104KB8NNNC" type="X7R"
C7: cap; 47µ; V=25 Irms=0 Rser=0 Lser=0 mfg="KEMET" pn="ESH476M025AC3AA" type="ESH"
C8: cap; 0.1µ; V=50 Irms=0 Rser=0.01 Lser=1000p mfg="Samsung Electro-Mechanics" pn="CL10B104KB8NNNC" type="X7R"
C9: cap; 47µ; V=25 Irms=0 Rser=0 Lser=0 mfg="KEMET" pn="ESH476M025AC3AA" type="ESH"
C10: cap; 681p; V=50 Irms=0 Rser=0.002 Lser=800p mfg="Murata" pn="GRM0335C1H681JE01D" type="C0G/NP0"
C11: cap; 681p; V=50 Irms=0 Rser=0.002 Lser=800p mfg="Murata" pn="GRM0335C1H681JE01D" type="C0G/NP0"
C12: cap; 0.1µ; V=50 Irms=0 Rser=0.01 Lser=1000p mfg="Samsung Electro-Mechanics" pn="CL10B104KB8NNNC" type="X7R"
C13: cap; 47µ; V=25 Irms=0 Rser=0 Lser=0 mfg="KEMET" pn="ESH476M025AC3AA" type="ESH"
C14: cap; 0.1µ; V=50 Irms=0 Rser=0.01 Lser=1000p mfg="Samsung Electro-Mechanics" pn="CL10B104KB8NNNC" type="X7R"
C15: cap; 47µ; V=25 Irms=0 Rser=0 Lser=0 mfg="KEMET" pn="ESH476M025AC3AA" type="ESH"
C16: cap; 0.1µ; V=50 Irms=0 Rser=0.01 Lser=1000p mfg="Samsung Electro-Mechanics" pn="CL10B104KB8NNNC" type="X7R"
C17: cap; 100p; V=50 Irms=0 Rser=0.1 Lser=500p mfg="Samsung Electro-Mechanics" pn="CL05C101JB5NNNC" type="C0G/NP0"
C18: cap; 100p; V=50 Irms=0 Rser=0.1 Lser=500p mfg="Samsung Electro-Mechanics" pn="CL05C101JB5NNNC" type="C0G/NP0"
C19: cap; 10µ; V=50 Irms=0 Rser=0 Lser=500p mfg="Samsung Electro-Mechanics" pn="CL31A106MBHNNNE" type="X5R"
C20: cap; 10µ; V=50 Irms=0 Rser=0 Lser=500p mfg="Samsung Electro-Mechanics" pn="CL31A106MBHNNNE" type="X5R"
C21: cap; 10µ; V=50 Irms=0 Rser=0 Lser=500p mfg="Samsung Electro-Mechanics" pn="CL31A106MBHNNNE" type="X5R"
C22: cap; 10µ; V=50 Irms=0 Rser=0 Lser=500p mfg="Samsung Electro-Mechanics" pn="CL31A106MBHNNNE" type="X5R"
C23: cap; 0.1µ; V=50 Irms=0 Rser=0.01 Lser=1000p mfg="Samsung Electro-Mechanics" pn="CL10B104KB8NNNC" type="X7R"
C24: cap; 1µ; V=50 Irms=0 Rser=0 Lser=0 mfg="Samsung Electro-Mechanics" pn="CL21B105KBFNNNE" type="X7R"
C25: cap; 0.1µ; V=50 Irms=0 Rser=0.01 Lser=1000p mfg="Samsung Electro-Mechanics" pn="CL10B104KB8NNNC" type="X7R"
C26: cap; 1µ; V=50 Irms=0 Rser=0 Lser=0 mfg="Samsung Electro-Mechanics" pn="CL21B105KBFNNNE" type="X7R"
C27: cap; 0.1µ; V=50 Irms=0 Rser=0.01 Lser=1000p mfg="Samsung Electro-Mechanics" pn="CL10B104KB8NNNC" type="X7R"
C28: cap; 100µ; V=25 Irms=0 Rser=0 Lser=0 mfg="KEMET" pn="ESK107M025AC3AA" type="ESK"
C29: cap; 100µ; V=25 Irms=0 Rser=0 Lser=0 mfg="KEMET" pn="ESK107M025AC3AA" type="ESK"
C30: cap; 100µ; V=25 Irms=0 Rser=0 Lser=0 mfg="KEMET" pn="ESK107M025AC3AA" type="ESK"
C31: cap; 100µ; V=25 Irms=0 Rser=0 Lser=0 mfg="KEMET" pn="ESK107M025AC3AA" type="ESK"
Q1: npn; Qmj15024
Q2: npn; Qmj15024
Q3: npn; Qmj15024
Q4: npn; Qmj15024
Q5: npn; Qmj15024
Q6: npn; Qmj15024
Q7: npn; Qmj15024
Q8: npn; Qmj15024
R1: res; 82
R2: res; 20m; tol=1 pwr=1 mfg="Vishay " pn="WSL2010R0200FEA18"
R3: res; 100; tol=1 pwr=0.1 mfg="Yageo" pn="RC0603FR-07100RL"
R4: res; 220K; tol=0.1 pwr=0.125 mfg="Yageo" pn="RT0805BRD07220KL"
R5: res; 5.1K; tol=0.1 pwr=0.1 mfg="Yageo" pn="RT0603BRD075K1L"
R6: res; 5.1K; tol=0.1 pwr=0.1 mfg="Yageo" pn="RT0603BRD075K1L"
R7: res; 220K; tol=0.1 pwr=0.125 mfg="Yageo" pn="RT0805BRD07220KL"
R8: res; 0.01
R9: res; 7.5
R10: res; 0.01
R11: res; 7.5
R12: res; 0.01
R13: res; 7.5
R14: res; 0.01
R15: res; 7.5
R16: res; 0.01
R17: res; 7.5
R18: res; 0.01
R19: res; 7.5
R20: res; 0.01
R21: res; 7.5
R22: res; 0.01
R23: res; 7.5
R24: res; 20K; tol=1 pwr=0.063 mfg="Yageo" pn="RC0402FR-0720KL"
R25: res; 20K; tol=1 pwr=0.063 mfg="Yageo" pn="RC0402FR-0720KL"
R26: res; 4.7K; tol=1 pwr=0.1 mfg="Yageo" pn="RC0603FR-074K7L"
R27: res; 4.7K; tol=1 pwr=0.1 mfg="Yageo" pn="RC0603FR-074K7L"
R28: res; 1K; tol=1 pwr=0.1 mfg="Yageo" pn="RC0603FR-071KL"
R29: res; 10K; tol=0.5 pwr=0.125 mfg="Stackpole Electronics" pn="RNCF0805DTC10K0"
R30: res; 10K; tol=0.5 pwr=0.125 mfg="Stackpole Electronics" pn="RNCF0805DTC10K0"
R31: res; 1Meg; tol=1 pwr=0.1 mfg="Yageo" pn="RC0603FR-071ML"
R32: res; 1Meg; tol=1 pwr=0.1 mfg="Yageo" pn="RC0603FR-071ML"
R33: res; 1K; tol=1 pwr=0.1 mfg="Yageo" pn="RC0603FR-071KL"
R38: res; 9K
R39: res; 1K; tol=1 pwr=0.1 mfg="Yageo" pn="RC0603FR-071KL"
U1: OPAx197
U2: irlz44n
U3: LM358
U4: SSA2_250
U5: OPAx197
U6: OPAx197
U9: AP7363
U10: MIC69502
U11: L78M
U12: L78M
V1: voltage; ""
V2: voltage; 30
V3: voltage; 3.3
V5: voltage; 5
V6: voltage; 8
V7: voltage; 8
Named nets: 0, +5V, +8V, -8V, VCCS_OUT, MAIN_IN-, MAIN_IN+, SSA_GND, SSA_VCC, DIFF_SSA_VO+, DIFF_SSA_VO-, I_SENSE, V_SENSE, REMOTE_SENSE+, REMOTE_SENSE-, +3.3V, UR_+5.5V, UR_+12V, UR_-12V, VCCS_IN
.dc V1 0.01 3.3 0.04
VCCS
Prototyped and tested
0-3.3V -> 0-4A
.include MJ15024.LIB
POWER ELECTRONICS
SENSE AMPLIFIERS
.include dummy_ldo.lib
FRONT PANEL - INTERNALS
VOLTAGE REGULATION
