CharlieW112/PROJ300/(list of files, drawings)

Other design files:
KiCAD/Analogue Board/Analogue Board/freerouting.dsn
KiCAD/Analogue Board/Analogue Board/temp-freerouting.dsn
