CharlieW112/PROJ300/KiCAD/MCU Board/MCU Board/MCU Board.kicad_pcb

## KiCad design KiCAD/MCU Board/MCU Board/MCU Board.kicad_pcb (2025-05-07)

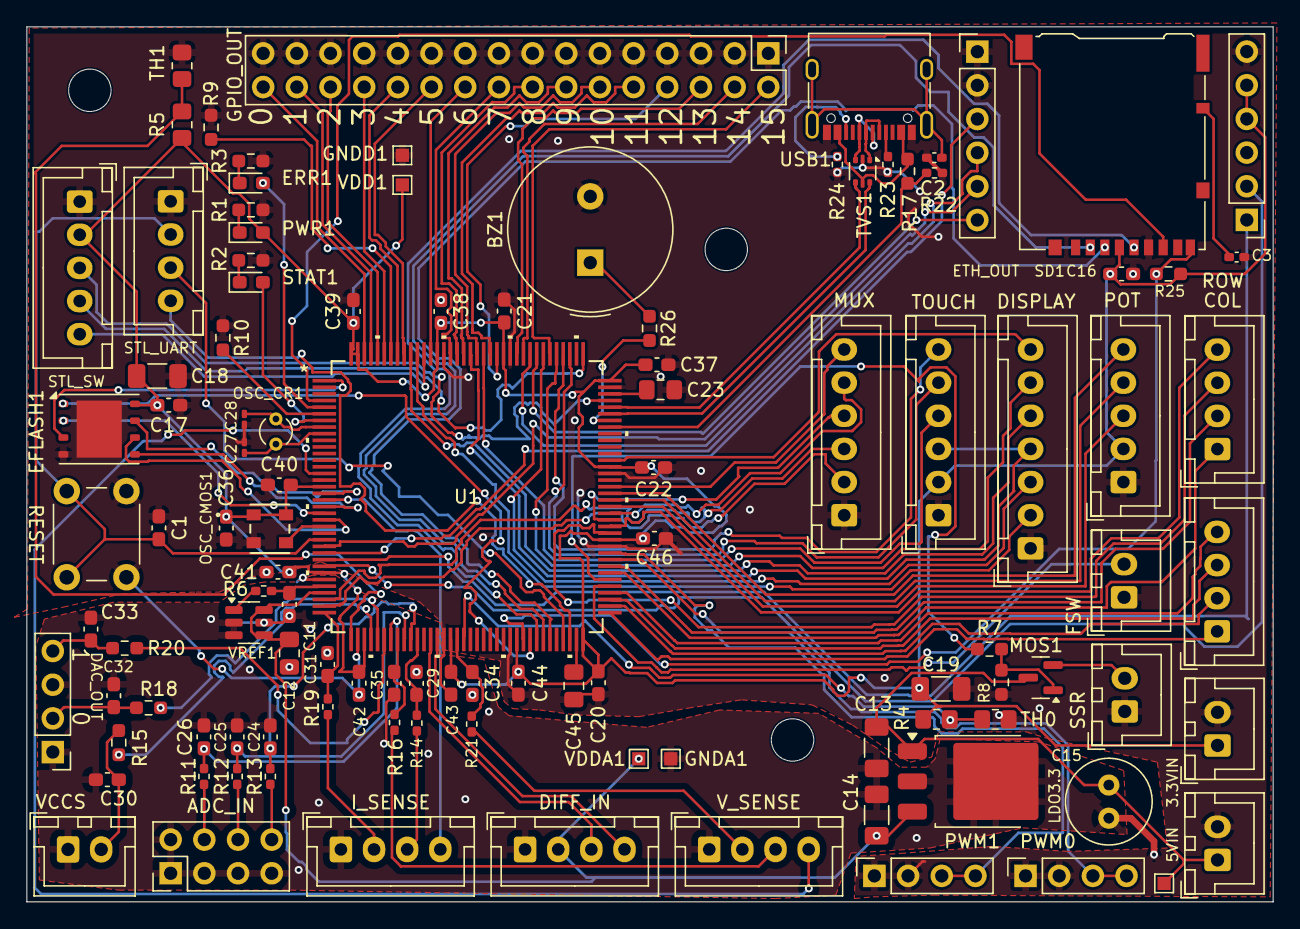
[picture p77: board MCU Board.kicad_pcb from above]

Board: 2 copper layers, 94.0 x 66.0 mm, 114 parts (0 on the bottom side), 127 nets.

Parts:
3.3VIN, 5VIN: Conn_01x02; JST_XH_B2B-XH-A_1x02_P2.50mm_Vertical
5VIN2: TestPoint; TestPoint_Pad_1.0x1.0mm
ADC_IN: Conn_02x04_Odd_Even; PinHeader_2x04_P2.54mm_Vertical
BZ1: Buzzer; Buzzer_TDK_PS1240P02BT_D12.2mm_H6.5mm
C1: 100n; C_0603_1608Metric_Pad1.08x0.95mm_HandSolder
C2, C3: 10n; C_0402_1005Metric_Pad0.74x0.62mm_HandSolder
C11, C16, C17, C21, C22, C24, C25, C26, C29, C30, C31, C32, C33, C34, C35, C36, C37, C38, C39, C40, C41, C42, C43, C44, C45, C46: 0.1u; C_0603_1608Metric_Pad1.08x0.95mm_HandSolder
C12, C20, C23: 1u; C_0805_2012Metric_Pad1.18x1.45mm_HandSolder
C13, C14, C18, C19: 10u; C_1206_3216Metric_Pad1.33x1.80mm_HandSolder
C15: 100u; C_Radial_D6.3mm_H11.0mm_P2.50mm
C27, C28: 10p; C_0201_0603Metric_Pad0.64x0.40mm_HandSolder
COL: Conn_01x04; JST_XH_B4B-XH-A_1x04_P2.50mm_Vertical
DAC_OUT: Conn_01x04; PinHeader_1x04_P2.54mm_Vertical
DIFF_IN: Conn_01x04; JST_XH_B4B-XH-A_1x04_P2.50mm_Vertical
DISPLAY: Conn_01x07; JST_XH_B7B-XH-A_1x07_P2.50mm_Vertical
EFLASH1: W25Q128JVP; WSON-8-1EP_6x5mm_P1.27mm_EP3.4x4.3mm
ERR1: Red LED; D_0603_1608Metric_Pad1.05x0.95mm_HandSolder
ETH_OUT, ETH_OUT1: Conn_01x06; PinHeader_1x06_P2.54mm_Vertical
FSW: Conn_01x02; JST_XH_B2B-XH-A_1x02_P2.50mm_Vertical
GNDA1: TestPoint; TestPoint_Pad_1.0x1.0mm
GNDD1: TestPoint; TestPoint_Pad_1.0x1.0mm
GPIO_OUT: Conn_02x16_Odd_Even; PinHeader_2x16_P2.54mm_Vertical
H1, H2, H3: MountingHole; MountingHole_3.2mm_M3
I_SENSE: Conn_01x04; JST_XH_B4B-XH-A_1x04_P2.50mm_Vertical
LDO3.3: TO-252-3_TabPin2
MOS1: AO3400A; SOT-23
MUX: Conn_01x06; JST_XH_B6B-XH-A_1x06_P2.50mm_Vertical
NT1: NetTie_2; NetTie-2_SMD_Pad0.5mm
OSC_CMOS1: COM1305-25.000; SMD4_COM1305_2p5x3p2x1p0_RAL-M
OSC_CR1: AB26T-32.768KHZ; Crystal_C26-LF_D2.1mm_L6.5mm_Vertical
POT: Conn_01x05; JST_XH_B5B-XH-A_1x05_P2.50mm_Vertical
PWM0, PWM1: Conn_01x04; PinSocket_1x04_P2.54mm_Vertical
PWR1: Green LED; D_0603_1608Metric_Pad1.05x0.95mm_HandSolder
R1, R2, R3, R7: 1K; R_0603_1608Metric_Pad0.98x0.95mm_HandSolder
R4, R5: 10K 0.5%; R_0805_2012Metric_Pad1.20x1.40mm_HandSolder
R6: 10; R_0402_1005Metric_Pad0.72x0.64mm_HandSolder
R8, R10, R17, R25: 10K; R_0603_1608Metric_Pad0.98x0.95mm_HandSolder
R9: 10k; R_0603_1608Metric_Pad0.98x0.95mm_HandSolder
R11, R12, R13, R14, R16, R19, R21: 49.9; R_0402_1005Metric_Pad0.72x0.64mm_HandSolder
R15, R18, R20, R26: 100; R_0603_1608Metric_Pad0.98x0.95mm_HandSolder
R22: 20K; R_0402_1005Metric_Pad0.72x0.64mm_HandSolder
R23, R24: 5.1K; R_0402_1005Metric_Pad0.72x0.64mm_HandSolder
RESET: SW_Push; SW_PUSH_6mm_H9.5mm
ROW: Conn_01x04; JST_XH_B4B-XH-A_1x04_P2.50mm_Vertical
SD1: Micro_SD_Card_Det1; microSD_HC_Hirose_DM3AT-SF-PEJM5
SSR: Conn_01x02; JST_XH_B2B-XH-A_1x02_P2.50mm_Vertical
STAT1: Green LED; D_0603_1608Metric_Pad1.05x0.95mm_HandSolder
STL_SW: Conn_01x05; JST_XH_B5B-XH-A_1x05_P2.50mm_Vertical
STL_UART: Conn_01x04; JST_XH_B4B-XH-A_1x04_P2.50mm_Vertical
TH0, TH1: Thermistor_NTC; R_0805_2012Metric_Pad1.20x1.40mm_HandSolder
TOUCH: Conn_01x06; JST_XH_B6B-XH-A_1x06_P2.50mm_Vertical
TVS1: USBLC6-2P6; SOT-666
U1: STM32H7A3ZIT6; LQFP-144-M
USB1: USB_C_Receptacle_USB2.0_16P; USB_C_Receptacle_XKB_U262-16XN-4BVC11
VCCS: Conn_01x02; JST_XH_B2B-XH-A_1x02_P2.50mm_Vertical
VDD1: TestPoint; TestPoint_Pad_1.0x1.0mm
VDDA1: TestPoint; TestPoint_Pad_1.0x1.0mm
VREF1: MCP1501-33xCH; SOT-23-6
V_SENSE: Conn_01x04; JST_XH_B4B-XH-A_1x04_P2.50mm_Vertical

Connections:
3.3VREF: C11.1, R6.2, U1.32 (VREF+)
+5V: 5VIN.1, 5VIN2.1, C13.1, C15.1, LDO3.3.1 (IN), MOS1.3 (D)
/USB+: TVS1.3 (I/O2), USB1.A6 (D+), USB1.B6 (D+)
/USB-: TVS1.1 (I/O1), USB1.A7 (D-), USB1.B7 (D-)
ADC0_UNUSED: C26.1, R11.2, U1.43 (ADC0_UNUSED)
ADC1_UNUSED: C25.1, R12.2, U1.45 (ADC1_UNUSED)
ADC2_UNUSED: C24.1, R13.2, U1.46 (ADC2_UNUSED)
ADC_DIFF_N: DIFF_IN.4, U1.50 (ADC_DIFF_N)
ADC_DIFF_P: DIFF_IN.3, U1.49 (ADC_DIFF_P)
ADC_ISENSEC: C29.2, R14.1, U1.47 (ADC_ISENSEC)
ADC_ISENSEF: C31.1, R19.1, U1.36 (ADC_ISENSEF)
ADC_VCCSSENSE: C35.2, R16.1, U1.44 (ADC_VCCSSENSE)
ADC_VSENSE: C34.1, R21.1, U1.53 (ADC_VSENSE)
DAC0_UNUSED: R18.1, U1.41 (DAC0_UNUSED)
DAC1_UNUSED: R20.1, U1.42 (DAC1_UNUSED)
DAC_VCCS: R15.1, U1.40 (DAC_VCCS)
DISPL_CS: DISPLAY.2, U1.134 (DISPL_CS)
DISPL_DC: DISPLAY.6, U1.113 (DISPL_DC)
DISPL_LED: DISPLAY.7, U1.96 (DISPL_LED)
DISPL_MOSI: DISPLAY.5, U1.135 (DISPL_MOSI)
DISPL_RST: DISPLAY.3, U1.115 (DISPL_RST)
DISPL_SCK: DISPLAY.4, TOUCH.3, U1.126 (DISPL_SCK)
DTH2: R4.2, TH0.1, U1.54 (DTH2)
DTH3: R5.2, TH1.1, U1.37 (DTH3)
ENCODER_A: POT.3, U1.89 (ENCODER_A)
ENCODER_B: POT.4, U1.90 (ENCODER_B)
ENCODER_SW: POT.5, U1.91 (ENCODER_SW)
ERROR_LED: ERR1.2 (A), U1.5 (ERROR_LED)
ETH_CS: ETH_OUT.5, U1.26 (ETH_CS)
ETH_INT: ETH_OUT.6, U1.116 (ETH_INT)
ETH_MISO: ETH_OUT1.1, U1.28 (ETH_MISO)
ETH_MOSI: ETH_OUT.3, U1.27 (ETH_MOSI)
ETH_RST: ETH_OUT1.2, U1.29 (ETH_RST)
ETH_SCK: ETH_OUT.4, U1.117 (ETH_SCK)
E_FLASH_CLK: EFLASH1.6 (CLK), U1.22 (E_FLASH_CLK)
E_FLASH_CS: EFLASH1.1 (~CS), U1.64 (E_FLASH_CS)
E_FLASH_IO0: EFLASH1.5 (DI/IO_{0}), U1.20 (E_FLASH_IO0)
E_FLASH_IO1: EFLASH1.2 (DO/IO_{1}), U1.21 (E_FLASH_IO1)
E_FLASH_IO2: EFLASH1.3 (~WP/IO_{2}), U1.1 (E_FLASH_IO2)
E_FLASH_IO3: EFLASH1.7 (~HOLD/~RESET/IO_{3}), U1.18 (E_FLASH_IO3)
FRONT_SW: FSW.2, U1.77 (FRONT_SW)
GNDA: ADC_IN.1, ADC_IN.2, ADC_IN.3, ADC_IN.5, ADC_IN.7, C11.2, C12.2, C13.2, C14.2, C15.2, C24.2, C25.2, C26.2, C29.1, C30.1, C31.2, C32.1, C33.2, C34.2, C35.1, DAC_OUT.1, DAC_OUT.3, DIFF_IN.1, GNDA1.1, I_SENSE.1, LDO3.3.2 (GND), NT1.2, U1.31 (VSSA), VCCS.1, VREF1.2 (GND), VREF1.3 (GND), VREF1.5 (GND), V_SENSE.1
GNDD: 3.3VIN.2, 5VIN.2, BZ1.2 (-), C1.2, C2.2, C3.2, C16.1, C17.2, C18.2, C19.2, C20.2, C21.2, C22.2, C23.2, C27.2, C28.2, C36.2, C37.1, C38.1, C39.1, C40.1, C41.1, C42.1, C43.1, C44.1, C45.1, C46.1, DISPLAY.1, EFLASH1.4 (GND), EFLASH1.9 (EP), ETH_OUT.1, ETH_OUT.2, ETH_OUT1.6, FSW.1, GNDD1.1, GPIO_OUT.1, GPIO_OUT.3, GPIO_OUT.5, GPIO_OUT.7, GPIO_OUT.9, GPIO_OUT.11, GPIO_OUT.13, GPIO_OUT.15, GPIO_OUT.17, GPIO_OUT.19, GPIO_OUT.21, GPIO_OUT.23, GPIO_OUT.25, GPIO_OUT.27, GPIO_OUT.29, GPIO_OUT.31, MUX.1, NT1.1, OSC_CMOS1.2 (GND), POT.1, PWM0.1, PWM0.2, PWM1.1, PWM1.2, R1.2, R2.2, R3.2, R8.2, R9.2, R10.1, R22.2, R23.2, R24.2, RESET.2, SD1.6 (VSS), SSR.1, STL_SW.1, STL_UART.1, TH0.2, TH1.2, TOUCH.1, TVS1.2 (GND), U1.16 (VSS), U1.38 (VSS), U1.51 (VSS), U1.61 (VSS), U1.83 (VSS), U1.94 (VSS), U1.107 (VSS), U1.120 (VSS), U1.130 (VSS), USB1.A1 (GND), USB1.A12 (GND), USB1.B1 (GND), USB1.B12 (GND)
GPIO0_UNUSED: GPIO_OUT.32, U1.142 (GPIO0_UNUSED)
GPIO1_UNUSED: GPIO_OUT.30, U1.141 (GPIO1_UNUSED)
GPIO2_UNUSED: GPIO_OUT.28, U1.140 (GPIO2_UNUSED)
GPIO3_UNUSED: GPIO_OUT.26, U1.139 (GPIO3_UNUSED)
GPIO4_UNUSED: GPIO_OUT.24, U1.137 (GPIO4_UNUSED)
GPIO5_UNUSED: GPIO_OUT.22, U1.136 (GPIO5_UNUSED)
GPIO6_UNUSED: GPIO_OUT.20, U1.132 (GPIO6_UNUSED)
GPIO7_UNUSED: GPIO_OUT.18, U1.129 (GPIO7_UNUSED)
GPIO8_UNUSED: GPIO_OUT.16, U1.128 (GPIO8_UNUSED)
GPIO9_UNUSED: GPIO_OUT.14, U1.127 (GPIO9_UNUSED)
GPIO10_UNUSED: GPIO_OUT.12, U1.125 (GPIO10_UNUSED)
GPIO11_UNUSED: GPIO_OUT.10, U1.123 (GPIO11_UNUSED)
GPIO12_UNUSED: GPIO_OUT.8, U1.122 (GPIO12_UNUSED)
GPIO13_UNUSED: GPIO_OUT.6, U1.119 (GPIO13_UNUSED)
GPIO14_UNUSED: GPIO_OUT.4, U1.118 (GPIO14_UNUSED)
GPIO15_UNUSED: GPIO_OUT.2, U1.114 (GPIO15_UNUSED)
GPIO_I_SENSE_EN: I_SENSE.4, U1.19 (PF7)
GPIO_WARNING_HV: U1.15 (PF5), V_SENSE.4
HSE_OSC: OSC_CMOS1.3 (OUT), U1.23 (HSE_OSC)
MATC0: COL.1, U1.73 (MATC0)
MATC1: COL.2, U1.74 (MATC1)
MATC2: COL.3, U1.75 (MATC2)
MATC3: COL.4, U1.76 (MATC3)
MATR0: ROW.1, U1.79 (MATR0)
MATR1: ROW.2, U1.80 (MATR1)
MATR2: ROW.3, U1.85 (MATR2)
MATR3: ROW.4, U1.86 (MATR3)
MUX_A: MUX.4, U1.87 (PG2)
MUX_B: MUX.5, U1.88 (PG3)
MUX_C: MUX.6, U1.92 (PG7)
MUX_TH0: MUX.2, U1.35 (MUX_TH0)
MUX_TH1: MUX.3, U1.34 (MUX_TH1)
NRST: C1.1, RESET.1, STL_UART.2, U1.25 (NRST)
unnamed: ADC_IN.4, R11.1
unnamed: ADC_IN.6, R12.1
unnamed: ADC_IN.8, R13.1
unnamed: BZ1.1 (+), R26.2
unnamed: C32.2, DAC_OUT.2, R18.2
unnamed: C33.1, DAC_OUT.4, R20.2
unnamed: ERR1.1 (K), R3.1
unnamed: I_SENSE.2, R19.2
unnamed: I_SENSE.3, R14.2
unnamed: MOS1.1 (G), R7.2, R8.1
unnamed: PWR1.1 (K), R1.1
unnamed: C3.1, SD1.10 (SHIELD)
unnamed: R2.1, STAT1.1 (K)
unnamed: R17.1, TVS1.5 (VBUS), USB1.A4 (VBUS), USB1.A9 (VBUS), USB1.B4 (VBUS), USB1.B9 (VBUS)
unnamed: R10.2, U1.6 (VBAT)
unnamed: C20.1, U1.71 (VCAP)
unnamed: R9.1, U1.138 (BOOT0)
unnamed: C23.1, U1.106 (VCAP)
unnamed: R23.1, USB1.A5 (CC1)
unnamed: R24.1, USB1.B5 (CC2)
unnamed: C2.1, USB1.S1 (SHIELD)
unnamed: C30.2, R15.2, VCCS.2
unnamed: R6.1, VREF1.1 (OUT)
unnamed: R21.2, V_SENSE.2
unnamed: R16.2, V_SENSE.3
PWM0: PWM0.3, PWM0.4, U1.81 (PWM0)
PWM1: PWM1.3, PWM1.4, U1.82 (PWM1)
PWM_BUZZER: R26.1, U1.102 (PA10)
RTC_OSC_IN: C28.1, OSC_CR1.1, U1.8 (RTC_OSC_IN)
RTC_OSC_OUT: C27.1, OSC_CR1.2, U1.9 (RTC_OSC_OUT)
SD_CARD_DETECT: R25.1, SD1.9 (DET), U1.63 (SD_CARD_DETECT)
SD_CS: SD1.2 (DAT3/CD), U1.66 (SD_CS)
SD_MISO: SD1.7 (DAT0), U1.4 (SD_MISO)
SD_MOSI: SD1.3 (CMD), U1.67 (SD_MOSI)
SD_SCK: SD1.5 (CLK), U1.65 (SD_SCK)
SSR_EN: R7.1, U1.78 (SSR_EN)
SSR_OUT: MOS1.2 (S), SSR.2
STATUS_LED: STAT1.2 (A), U1.7 (STATUS_LED)
ST_LINK_RX: STL_UART.4, U1.70 (ST_LINK_RX)
ST_LINK_SWCLK: STL_SW.4, U1.109 (ST_LINK_SWCLK)
ST_LINK_SWDIO: STL_SW.3, U1.105 (ST_LINK_SWDIO)
ST_LINK_SWO: STL_SW.5, U1.133 (ST_LINK_SWO)
ST_LINK_TX: STL_UART.3, U1.69 (ST_LINK_TX)
TOUCH_CS: TOUCH.5, U1.111 (TOUCH_CS)
TOUCH_INT: TOUCH.6, U1.112 (TOUCH_INT)
TOUCH_MISO: TOUCH.4, U1.124 (TOUCH_MISO)
USB_DM: TVS1.6 (I/O1), U1.103 (USB_DM)
USB_DP: TVS1.4 (I/O2), U1.104 (USB_DP)
USB_VBUS: R17.2, R22.1, U1.101 (USB_VBUS)
VDD: 3.3VIN.1, C16.2, C17.1, C18.1, C19.1, C21.1, C22.1, C36.1, C37.2, C38.2, C39.2, C40.2, C41.2, C42.2, C43.2, C44.2, C45.2, C46.2, EFLASH1.8 (VCC), ETH_OUT1.4, ETH_OUT1.5, OSC_CMOS1.1 (EN), OSC_CMOS1.4 (Vdd), POT.2, PWR1.2 (A), R4.1, R5.1, R25.2, SD1.4 (VDD), STL_SW.2, TOUCH.2, U1.17 (VDD), U1.30 (VDD), U1.39 (VDD), U1.52 (VDD), U1.62 (VDD), U1.72 (VDD), U1.84 (VDD), U1.95 (VDD33USB), U1.108 (VDD), U1.121 (VDDMMC), U1.131 (VDD), U1.143 (PDR_ON), U1.144 (VDD), VDD1.1
VDDA: C12.1, C14.1, DIFF_IN.2, LDO3.3.3 (OUT), U1.33 (VDDA), VDDA1.1, VREF1.4 (~SHDN), VREF1.6 (VDD)
