CharlieW112/PROJ300/KiCAD/PWM Board/PWM Board/PWM Board.kicad_pcb

## KiCad design KiCAD/PWM Board/PWM Board/PWM Board.kicad_pcb (2025-05-07)

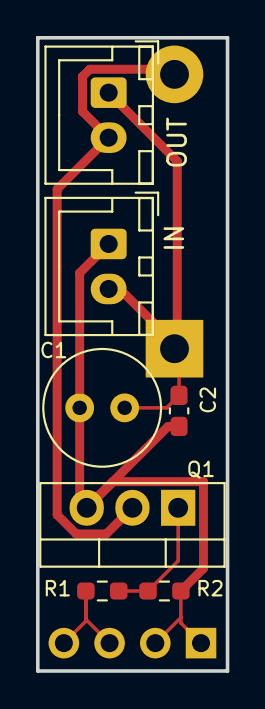
[picture p82: board PWM Board.kicad_pcb from above]

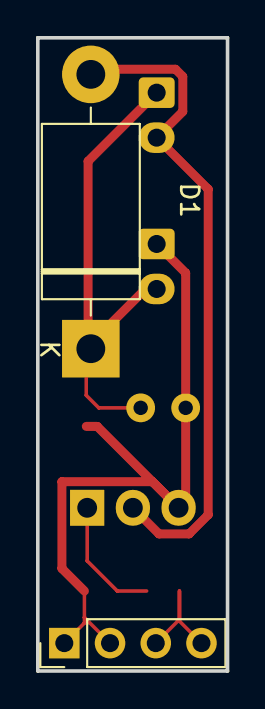
[picture p83: board PWM Board.kicad_pcb from below]

Board: 2 copper layers, 10.5 x 35.2 mm, 9 parts (2 on the bottom side), 5 nets.

Parts:
C1: 47u; C_Radial_D6.3mm_H11.0mm_P2.50mm
C2: 0.1u; C_0603_1608Metric_Pad1.08x0.95mm_HandSolder
D1: 1N5822; D_DO-201AD_P15.24mm_Horizontal
IN: Conn_01x02; JST_XH_B2B-XH-A_1x02_P2.50mm_Vertical
J1: Conn_01x04; PinHeader_1x04_P2.54mm_Vertical
OUT: Conn_01x02; JST_XH_B2B-XH-A_1x02_P2.50mm_Vertical
Q1: IRLZ44N; TO-220-3_Vertical
R1: 100; R_0603_1608Metric_Pad0.98x0.95mm_HandSolder
R2: 10K; R_0603_1608Metric_Pad0.98x0.95mm_HandSolder

Connections:
GND: C1.2, C2.2, IN.1, J1.1, J1.2, Q1.3 (S), R2.1
unnamed: D1.2 (A), OUT.2, Q1.2 (D)
unnamed: C1.1, C2.1, D1.1 (K), IN.2, OUT.1
unnamed: J1.3, J1.4, R1.1
unnamed: Q1.1 (G), R1.2, R2.2
