CharlieW112/PROJ300/MCU Code/Src/main.c

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
/* Includes ------------------------------------------------------------------*/
#include "main.h"
#include "app_touchgfx.h"
#include "usb_device.h"

/* USER CODE BEGIN Includes */
#include "core_cm7.h"  // Needed for ITM
#include "dfu_jump.h"
#include "sensors.h"

/* USER CODE END Includes */

/* USER CODE BEGIN PD */
#define ITM_TCR_TXENA_Msk (1UL << 3)
/* USER CODE END PD */

ADC_HandleTypeDef hadc1;
ADC_HandleTypeDef hadc2;
DMA_HandleTypeDef hdma_adc1;
DMA_HandleTypeDef hdma_adc2;

CRC_HandleTypeDef hcrc;

DAC_HandleTypeDef hdac1;
DAC_HandleTypeDef hdac2;

RTC_HandleTypeDef hrtc;

SPI_HandleTypeDef hspi1;

TIM_HandleTypeDef htim1;
TIM_HandleTypeDef htim3;
TIM_HandleTypeDef htim4;
TIM_HandleTypeDef htim8;
TIM_HandleTypeDef htim12;
TIM_HandleTypeDef htim15;

UART_HandleTypeDef huart3;

/* USER CODE BEGIN PV */
uint16_t adc1_dma_buf[ADC1_DMA_BUF_LEN];
uint16_t adc2_dma_buf[ADC2_DMA_BUF_LEN];

/* USER CODE END PV */

void SystemClock_Config(void);
void PeriphCommonClock_Config(void);
static void MPU_Config(void);
static void MX_GPIO_Init(void);
static void MX_DMA_Init(void);
static void MX_ADC1_Init(void);
static void MX_ADC2_Init(void);
static void MX_DAC1_Init(void);
static void MX_DAC2_Init(void);
static void MX_RTC_Init(void);
static void MX_SPI1_Init(void);
static void MX_TIM4_Init(void);
static void MX_TIM8_Init(void);
static void MX_USART3_UART_Init(void);
static void MX_TIM1_Init(void);
static void MX_CRC_Init(void);
static void MX_TIM3_Init(void);
static void MX_TIM12_Init(void);
static void MX_TIM15_Init(void);
/* USER CODE BEGIN PFP */
static void SWO_Init(void);
static void DAC_Calibrate();

void DISPL_Select(void);
void DISPL_Unselect(void);
void DISPL_DC_Command(void);
void DISPL_DC_Data(void);
void DISPL_Reset(void);
void DISPL_SendCommand(uint8_t cmd);
void DISPL_SendData(uint8_t *buff, size_t buff_size);
void DISPL_SendDataByte(uint8_t data);
void Test_Display(void);
/* USER CODE END PFP */

/* USER CODE BEGIN 0 */
int _write(int file, char *ptr, int len)
{
    for (int i = 0; i < len; i++)
    {
        ITM_SendChar(ptr[i]);
    }
    return len;
}

/* USER CODE END 0 */

/**
  * @brief  The application entry point.
  * @retval int
  */
int main(void)
{

  /* MPU Configuration--------------------------------------------------------*/
  MPU_Config();

  /* MCU Configuration--------------------------------------------------------*/

  /* Reset of all peripherals, Initializes the Flash interface and the Systick. */
  HAL_Init();

  /* USER CODE BEGIN Init */
  bootloader_check();


  /* USER CODE END Init */

  /* Configure the system clock */
  SystemClock_Config();

  /* Configure the peripherals common clocks */
  PeriphCommonClock_Config();

  /* USER CODE BEGIN SysInit */
  SWO_Init();

  /* USER CODE END SysInit */

  /* Initialize all configured peripherals */
  MX_GPIO_Init();
  MX_DMA_Init();
  MX_ADC1_Init();
  MX_ADC2_Init();
  MX_DAC1_Init();
  MX_DAC2_Init();
  MX_RTC_Init();
  MX_SPI1_Init();
  MX_TIM4_Init();
  MX_TIM8_Init();
  MX_USART3_UART_Init();
  MX_TIM1_Init();
  MX_USB_DEVICE_Init();
  MX_CRC_Init();
  MX_TIM3_Init();
  MX_TIM12_Init();
  MX_TIM15_Init();
  MX_TouchGFX_Init();
  /* USER CODE BEGIN 2 */

  Displ_Init(Displ_Orientat_0);			// initialize display controller - set orientation parameter as per TouchGFX setup
  Displ_BackLight('I');  					// initialize backlight
  HAL_TIM_Base_Start_IT(&TGFX_T);			// start TouchGFX tick timer

  HAL_ADC_Start_DMA(&hadc1, (uint32_t*)adc1_dma_buf, ADC1_DMA_BUF_LEN);
  HAL_ADC_Start_DMA(&hadc2, (uint32_t*)adc2_dma_buf, ADC2_DMA_BUF_LEN);
  HAL_DAC_Start(&hdac1, DAC_CHANNEL_1);

  sensors_init();

  DAC_Calibrate();

  thermistor_mux_init();
  HAL_TIM_Base_Start_IT(&htim12);


  HAL_TIM_Base_Start_IT(&htim15);


  /* USER CODE END 2 */

  /* Infinite loop */
  /* USER CODE BEGIN WHILE */
  while (1)
  {
    /* USER CODE END WHILE */

  MX_TouchGFX_Process();
    /* USER CODE BEGIN 3 */

  control_current();

  static uint32_t last_print_time = 0;
    if (HAL_GetTick() - last_print_time >= 250)
    {
    	//Test_Display();
        last_print_time = HAL_GetTick();

    	sensors_debug_print();
    	//thermistor_mux_debug_print();
    }
  }
  /* USER CODE END 3 */
}

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
/* USER CODE BEGIN 4 */
void DAC_Calibrate(void)
{
    DAC_ChannelConfTypeDef sConfig = {0};

    // Stop the DAC before calibration
    HAL_DAC_Stop(&hdac1, DAC_CHANNEL_1);

    // Perform self-calibration
    if (HAL_DACEx_SelfCalibrate(&hdac1, &sConfig, DAC_CHANNEL_1) != HAL_OK)
    {
        Error_Handler();
    }

    // Restart the DAC
    HAL_DAC_Start(&hdac1, DAC_CHANNEL_1);
}

void SWO_Init(void)
{
    CoreDebug->DEMCR |= CoreDebug_DEMCR_TRCENA_Msk;
    ITM->LAR = 0xC5ACCE55;
    ITM->TCR = ITM_TCR_ITMENA_Msk | ITM_TCR_SYNCENA_Msk |
               ITM_TCR_TSENA_Msk  | ITM_TCR_TXENA_Msk;
    ITM->TER = 1;

    TPI->ACPR = (SystemCoreClock / 2000000) - 1; // Set SWO speed to 2MHz
    TPI->SPPR = 0x00000002;  // NRZ protocol
    TPI->CSPSR = 1;          // Port size = 1 bit
    TPI->FFCR = 0x00000100;  // Disable formatter
}

/* USER CODE END 4 */

 /* MPU Configuration */

void MPU_Config(void)
{
  MPU_Region_InitTypeDef MPU_InitStruct = {0};

  /* Disables the MPU */
  HAL_MPU_Disable();

  /** Initializes and configures the Region and the memory to be protected
  */
  MPU_InitStruct.Enable = MPU_REGION_ENABLE;
  MPU_InitStruct.Number = MPU_REGION_NUMBER0;
  MPU_InitStruct.BaseAddress = 0x0;
  MPU_InitStruct.Size = MPU_REGION_SIZE_4GB;
  MPU_InitStruct.SubRegionDisable = 0x87;
  MPU_InitStruct.TypeExtField = MPU_TEX_LEVEL0;
  MPU_InitStruct.AccessPermission = MPU_REGION_NO_ACCESS;
  MPU_InitStruct.DisableExec = MPU_INSTRUCTION_ACCESS_DISABLE;
  MPU_InitStruct.IsShareable = MPU_ACCESS_SHAREABLE;
  MPU_InitStruct.IsCacheable = MPU_ACCESS_NOT_CACHEABLE;
  MPU_InitStruct.IsBufferable = MPU_ACCESS_NOT_BUFFERABLE;

  HAL_MPU_ConfigRegion(&MPU_InitStruct);
  /* Enables the MPU */
  HAL_MPU_Enable(MPU_PRIVILEGED_DEFAULT);

}

/**
  * @brief  Period elapsed callback in non blocking mode
  * @note   This function is called  when TIM6 interrupt took place, inside
  * HAL_TIM_IRQHandler(). It makes a direct call to HAL_IncTick() to increment
  * a global variable "uwTick" used as application time base.
  * @param  htim : TIM handle
  * @retval None
  */
void HAL_TIM_PeriodElapsedCallback(TIM_HandleTypeDef *htim)
{
  if (htim->Instance == TIM6)
  {
    HAL_IncTick();
  }
  /* USER CODE BEGIN Callback 1 */
  else if (htim==&TGFX_T) touchgfxSignalVSync();
  else if (htim->Instance == TIM12) {
	  thermistor_mux_tick();
  }
  else if(htim->Instance == TIM15){
	  sensors_update();
  }
  /* USER CODE END Callback 1 */
}

/**
  * @brief  This function is executed in case of error occurrence.
  * @retval None
  */
void Error_Handler(void)
{
  /* USER CODE BEGIN Error_Handler_Debug */
  /* User can add his own implementation to report the HAL error return state */
  __disable_irq();
  while (1)
  {
  }
  /* USER CODE END Error_Handler_Debug */
}

#ifdef  USE_FULL_ASSERT
/**
  * @brief  Reports the name of the source file and the source line number
  *         where the assert_param error has occurred.
  * @param  file: pointer to the source file name
  * @param  line: assert_param error line source number
  * @retval None
  */
void assert_failed(uint8_t *file, uint32_t line)
{
  /* USER CODE BEGIN 6 */
  /* User can add his own implementation to report the file name and line number,
     ex: printf("Wrong parameters value: file %s on line %d\r\n", file, line) */
  /* USER CODE END 6 */
}
#endif /* USE_FULL_ASSERT */
